harshddes/VacuumSystem-Arduino/docs/index/A000066-pins.md

# A000066 pin index

Package note: DIP-28 socket, ATmega328P-PU
Source schematic: `docs/uno-r3-dip-A000066/cad/UNO-TH_Rev3e.sch`
SHA-256: `f44b5a90b74757e91477fb3adb776ffc556d9ea5dd8cc6ef3c79c1bbba0aee23`

Each row is a header leg from the Eagle schematic. The net name is the name on that drawing. Chip legs are the worker or USB chip pins tied to the same net.

| Header | Pin | Manual name | Net | Chip on that net | Also on that net |
| --- | --- | --- | --- | --- | --- |
| AD | 1 | A0 | AD0 | ZU4.(ADC0)PC0) pad 23 | TP_A0.TESTP pad X |
| AD | 2 | A1 | AD1 | ZU4.(ADC1)PC1 pad 24 | TP_A1.TESTP pad X |
| AD | 3 | A2 | AD2 | ZU4.(ADC2)PC2 pad 25 | TP_A2.TESTP pad X |
| AD | 4 | A3 | AD3 | ZU4.(ADC3)PC3 pad 26 | TP_A3.TESTP pad X |
| AD | 5 | A4 | AD4/SDA | ZU4.(ADC4)PC4 pad 27 | TP_A4.TESTP pad X<br>IOH.9 pad 9 = 10x1F-H8.5<br>TP_SDA.TESTP pad X |
| AD | 6 | A5 | AD5/SCL | ZU4.(ADC5)PC5 pad 28 | TP_A5.TESTP pad X<br>IOH.10 pad 10 = 10x1F-H8.5<br>TP_SCL.TESTP pad X |
| ICSP | 1 |  | MISO | ZU4.(MISO)PB4 pad 18 | IOH.5 pad 5 = 10x1F-H8.5<br>TP_12.TESTP pad X |
| ICSP | 2 |  | +5V | U3.VCC pad 4 = ATMEGA16U2-MU(R)<br>U3.AVCC pad 32 = ATMEGA16U2-MU(R)<br>ZU4.VCC pad 7 | POWER.5 pad 5 = 8x1F-H8.5<br>POWER.2 pad 2 = 8x1F-H8.5<br>RN4.1 pad 3 = 1K<br>RN4.1 pad 4 = 1K<br>RN2.1 pad 2 = 1K<br>RN2.1 pad 3 = 1K<br>+ 19 more in pin-index.jsonl |
| ICSP | 3 |  | SCK | ZU4.(SCK)PB5 pad 19 | IOH.6 pad 6 = 10x1F-H8.5<br>TP_13.TESTP pad X<br>U5.+IN pad 5 = LMV358IDGKR |
| ICSP | 4 |  | MOSI | ZU4.(MOSI)PB3 pad 17 | IOH.4 pad 4 = 10x1F-H8.5<br>TP_11.TESTP pad X |
| ICSP | 5 |  | RESET | ZU4.RESET pad 1 | C5.2 pad 2 = 100n<br>RESET-EN.2 pad 2<br>RESET-EN.1 pad 1<br>RN1.1 pad 4 = 10K<br>RESET.4 pad 4 = TS42031-160R-TR-7260<br>RESET.3 pad 3 = TS42031-160R-TR-7260<br>+ 3 more in pin-index.jsonl |
| ICSP | 6 |  | GND | ZU4.GND pad 8<br>ZU4.AGND pad 22<br>U3.GND pad 3 = ATMEGA16U2-MU(R)<br>U3.PAD pad 33 = ATMEGA16U2-MU(R) | C6.1 pad 1 = 100n<br>C10.1 pad 1 = 100n<br>C2.1 pad 1 = 100n<br>PC2.- pad - = 47u<br>PC1.- pad - = 47u<br>POWER.6 pad 6 = 8x1F-H8.5<br>+ 22 more in pin-index.jsonl |
| ICSP1 | 1 |  | MISO2 | U3.(PD0/MISO/PCINT3)PB3 pad 17 = ATMEGA16U2-MU(R) | TP_MISO2.TESTP pad X |
| ICSP1 | 2 |  | +5V | U3.VCC pad 4 = ATMEGA16U2-MU(R)<br>U3.AVCC pad 32 = ATMEGA16U2-MU(R)<br>ZU4.VCC pad 7 | ICSP.2 pad 2 = 3x2 M<br>POWER.5 pad 5 = 8x1F-H8.5<br>POWER.2 pad 2 = 8x1F-H8.5<br>RN4.1 pad 3 = 1K<br>RN4.1 pad 4 = 1K<br>RN2.1 pad 2 = 1K<br>+ 19 more in pin-index.jsonl |
| ICSP1 | 3 |  | SCK2 | U3.(SCLK/PCINT1)PB1 pad 15 = ATMEGA16U2-MU(R) | TP_SCK2.TESTP pad X |
| ICSP1 | 4 |  | MOSI2 | U3.(PDI/MOSI/PCINT2)PB2 pad 16 = ATMEGA16U2-MU(R) | TP_MOSI2.TESTP pad X |
| ICSP1 | 5 |  | RESET2 | U3.RESET(PC1/DW) pad 24 = ATMEGA16U2-MU(R) | RN1.2 pad 6 = 10K<br>D3.A pad A = CD1206-S01575<br>TP_RESET2.TESTP pad X |
| ICSP1 | 6 |  | GND | ZU4.GND pad 8<br>ZU4.AGND pad 22<br>U3.GND pad 3 = ATMEGA16U2-MU(R)<br>U3.PAD pad 33 = ATMEGA16U2-MU(R) | ICSP.6 pad 6 = 3x2 M<br>C6.1 pad 1 = 100n<br>C10.1 pad 1 = 100n<br>C2.1 pad 1 = 100n<br>PC2.- pad - = 47u<br>PC1.- pad - = 47u<br>+ 22 more in pin-index.jsonl |
| IOH | 1 | D8 | IO8 | ZU4.(ICP)PB0 pad 14 | TP_8.TESTP pad X |
| IOH | 2 | D9 | IO9 | ZU4.(OC1)PB1 pad 15 | TP_9.TESTP pad X |
| IOH | 3 | D10 | SS | ZU4.(SS)PB2 pad 16 | TP_10.TESTP pad X |
| IOH | 4 | D11 | MOSI | ZU4.(MOSI)PB3 pad 17 | ICSP.4 pad 4 = 3x2 M<br>TP_11.TESTP pad X |
| IOH | 5 | D12 | MISO | ZU4.(MISO)PB4 pad 18 | ICSP.1 pad 1 = 3x2 M<br>TP_12.TESTP pad X |
| IOH | 6 | D13 | SCK | ZU4.(SCK)PB5 pad 19 | ICSP.3 pad 3 = 3x2 M<br>TP_13.TESTP pad X<br>U5.+IN pad 5 = LMV358IDGKR |
| IOH | 7 | GND | GND | ZU4.GND pad 8<br>ZU4.AGND pad 22<br>U3.GND pad 3 = ATMEGA16U2-MU(R)<br>U3.PAD pad 33 = ATMEGA16U2-MU(R) | ICSP.6 pad 6 = 3x2 M<br>C6.1 pad 1 = 100n<br>C10.1 pad 1 = 100n<br>C2.1 pad 1 = 100n<br>PC2.- pad - = 47u<br>PC1.- pad - = 47u<br>+ 22 more in pin-index.jsonl |
| IOH | 8 | AREF | AREF | ZU4.AREF pad 21 | C4.2 pad 2 = 100n<br>TP_AREF.TESTP pad X |
| IOH | 9 | A4/SD4 | AD4/SDA | ZU4.(ADC4)PC4 pad 27 | AD.5 pad 5 = 6x1F-H8.5<br>TP_A4.TESTP pad X<br>TP_SDA.TESTP pad X |
| IOH | 10 | A5/SD5 | AD5/SCL | ZU4.(ADC5)PC5 pad 28 | AD.6 pad 6 = 6x1F-H8.5<br>TP_A5.TESTP pad X<br>TP_SCL.TESTP pad X |
| IOL | 1 | D0 | IO0 | ZU4.(RXD)PD0 pad 2 | RN4.1 pad 2 = 1K<br>TP_0.TESTP pad X |
| IOL | 2 | D1 | IO1 | ZU4.(TXD)PD1 pad 3 | RN4.1 pad 1 = 1K<br>TP_1.TESTP pad X |
| IOL | 3 | D2 | IO2 | ZU4.(INT0)PD2 pad 4 | TP_2.TESTP pad X |
| IOL | 4 | D3 | IO3 | ZU4.(INT1)PD3 pad 5 | TP_3.TESTP pad X |
| IOL | 5 | D4 | IO4 | ZU4.(T0)PD4 pad 6 | TP_4.TESTP pad X |
| IOL | 6 | D5 | IO5 | ZU4.(T1)PD5 pad 11 | TP_5.TESTP pad X |
| IOL | 7 | D6 | IO6 | ZU4.(AIN0)PD6 pad 12 | TP_6.TESTP pad X |
| IOL | 8 | D7 | IO7 | ZU4.(AIN1)PD7 pad 13 | TP_7.TESTP pad X |
| JP2 | 1 |  | PB4 | U3.(T1/PCINT4)PB4 pad 18 = ATMEGA16U2-MU(R) | TP_PB4.TESTP pad X |
| JP2 | 2 |  | PB6 | U3.(PCINT6)PB6 pad 20 = ATMEGA16U2-MU(R) | TP_PB6.TESTP pad X |
| JP2 | 3 |  | PB5 | U3.(PCINT5)PB5 pad 19 = ATMEGA16U2-MU(R) | TP_PB5.TESTP pad X |
| JP2 | 4 |  | PB7 | U3.(PCINT7/OC0A/OC1C)PB7 pad 21 = ATMEGA16U2-MU(R) | TP_PB7.TESTP pad X |
| POWER | 1 | NC | (no wire) |  |  |
| POWER | 2 | IOREF | +5V | U3.VCC pad 4 = ATMEGA16U2-MU(R)<br>U3.AVCC pad 32 = ATMEGA16U2-MU(R)<br>ZU4.VCC pad 7 | ICSP.2 pad 2 = 3x2 M<br>RN4.1 pad 3 = 1K<br>RN4.1 pad 4 = 1K<br>RN2.1 pad 2 = 1K<br>RN2.1 pad 3 = 1K<br>C1.2 pad 2 = 100n<br>+ 18 more in pin-index.jsonl |
| POWER | 3 | Reset | RESET | ZU4.RESET pad 1 | ICSP.5 pad 5 = 3x2 M<br>C5.2 pad 2 = 100n<br>RESET-EN.2 pad 2<br>RESET-EN.1 pad 1<br>RN1.1 pad 4 = 10K<br>RESET.4 pad 4 = TS42031-160R-TR-7260<br>+ 3 more in pin-index.jsonl |
| POWER | 4 | +3V3 | +3V3 |  | C3.2 pad 2 = 1u<br>U2.OUT pad 5 = LP2985-33DBVR<br>TP_3V3.TESTP pad X<br>U5.-IN pad 2 = LMV358IDGKR |
| POWER | 5 | +5V | +5V | U3.VCC pad 4 = ATMEGA16U2-MU(R)<br>U3.AVCC pad 32 = ATMEGA16U2-MU(R)<br>ZU4.VCC pad 7 | ICSP.2 pad 2 = 3x2 M<br>RN4.1 pad 3 = 1K<br>RN4.1 pad 4 = 1K<br>RN2.1 pad 2 = 1K<br>RN2.1 pad 3 = 1K<br>C1.2 pad 2 = 100n<br>+ 18 more in pin-index.jsonl |
| POWER | 6 | GND | GND | ZU4.GND pad 8<br>ZU4.AGND pad 22<br>U3.GND pad 3 = ATMEGA16U2-MU(R)<br>U3.PAD pad 33 = ATMEGA16U2-MU(R) | ICSP.6 pad 6 = 3x2 M<br>C6.1 pad 1 = 100n<br>C10.1 pad 1 = 100n<br>C2.1 pad 1 = 100n<br>PC2.- pad - = 47u<br>PC1.- pad - = 47u<br>+ 21 more in pin-index.jsonl |
| POWER | 7 | GND | GND | ZU4.GND pad 8<br>ZU4.AGND pad 22<br>U3.GND pad 3 = ATMEGA16U2-MU(R)<br>U3.PAD pad 33 = ATMEGA16U2-MU(R) | ICSP.6 pad 6 = 3x2 M<br>C6.1 pad 1 = 100n<br>C10.1 pad 1 = 100n<br>C2.1 pad 1 = 100n<br>PC2.- pad - = 47u<br>PC1.- pad - = 47u<br>+ 21 more in pin-index.jsonl |
| POWER | 8 | VIN | VIN |  | U1.IN pad 3 = NCP1117ST50T3G<br>PC1.+ pad + = 47u<br>D1.C pad C = M7<br>TP_VIN.TESTP pad X<br>RN1.2 pad 8 = 10K |

## Worker chip

| Pin name | Pad | Port | Net |
| --- | --- | --- | --- |
| (ADC0)PC0) | 23 | PC0 | AD0 |
| (ADC1)PC1 | 24 | PC1 | AD1 |
| (ADC2)PC2 | 25 | PC2 | AD2 |
| (ADC3)PC3 | 26 | PC3 | AD3 |
| (ADC4)PC4 | 27 | PC4 | AD4/SDA |
| (ADC5)PC5 | 28 | PC5 | AD5/SCL |
| (AIN0)PD6 | 12 | PD6 | IO6 |
| (AIN1)PD7 | 13 | PD7 | IO7 |
| (ICP)PB0 | 14 | PB0 | IO8 |
| (INT0)PD2 | 4 | PD2 | IO2 |
| (INT1)PD3 | 5 | PD3 | IO3 |
| (MISO)PB4 | 18 | PB4 | MISO |
| (MOSI)PB3 | 17 | PB3 | MOSI |
| (OC1)PB1 | 15 | PB1 | IO9 |
| (RXD)PD0 | 2 | PD0 | IO0 |
| (SCK)PB5 | 19 | PB5 | SCK |
| (SS)PB2 | 16 | PB2 | SS |
| (T0)PD4 | 6 | PD4 | IO4 |
| (T1)PD5 | 11 | PD5 | IO5 |
| (TXD)PD1 | 3 | PD1 | IO1 |
| AGND | 22 | AGND | GND |
| AREF | 21 | AREF | AREF |
| AVCC | 20 | AVCC | AVCC |
| GND | 8 | GND | GND |
| RESET | 1 | RESET | RESET |
| VCC | 7 | VCC | +5V |
| XTAL1 | 9 | XTAL1 | XTAL1 |
| XTAL2 | 10 | XTAL2 | XTAL2 |
