harshddes/VacuumSystem-Arduino/docs/index/A000073-pins.md

# A000073 pin index

Package note: SMD, schematic value ATmega328P-MU
Source schematic: `docs/uno-r3-smd-A000073/cad/UNOSMD_V3.sch`
SHA-256: `a00be79309468536b36c90b12942b9729759bdf1a425e4f94c5a1e9a9fc9a688`

Each row is a header leg from the Eagle schematic. The net name is the name on that drawing. Chip legs are the worker or USB chip pins tied to the same net.

| Header | Pin | Manual name | Net | Chip on that net | Also on that net |
| --- | --- | --- | --- | --- | --- |
| ICSP | 1 |  | MISO | U4.PB4(MISO) pad 16 = ATMEGA328P-MU | J2.13 pad 13 = - |
| ICSP | 2 |  | +5V | U3.VCC pad 4 = 16U2<br>U3.AVCC pad 32 = 16U2<br>U4.VCC@1 pad 4 = ATMEGA328P-MU<br>U4.VCC@2 pad 6 = ATMEGA328P-MU | L2.1 pad 1 = 10uH<br>RN4.1 pad 3 = 1K<br>RN4.1 pad 4 = 1K<br>RN2.1 pad 2 = 1K<br>RN2.1 pad 3 = 1K<br>C1.2 pad 2 = 100n<br>+ 18 more in pin-index.jsonl |
| ICSP | 3 |  | SCK | U4.PB5(SCK) pad 17 = ATMEGA328P-MU | U5.+IN pad 5 = LMV358IDGKR<br>J2.14 pad 14 = - |
| ICSP | 4 |  | MOSI | U4.PB3(MOSI/OC2) pad 15 = ATMEGA328P-MU | J2.12 pad 12 = - |
| ICSP | 5 |  | RESET | U4.PC6(/RESET) pad 29 = ATMEGA328P-MU | C5.2 pad 2 = 100n<br>RESET-EN.2 pad 2<br>RESET-EN.1 pad 1<br>RN1.1 pad 4 = 10K<br>RESET.4 pad 4 = TS42031-160R-TR-7260<br>RESET.3 pad 3 = TS42031-160R-TR-7260<br>+ 2 more in pin-index.jsonl |
| ICSP | 6 |  | GND | U4.GND@1 pad 3 = ATMEGA328P-MU<br>U4.GND@2 pad 5 = ATMEGA328P-MU<br>U4.AGND pad 21 = ATMEGA328P-MU<br>U3.GND pad 3 = 16U2<br>U3.PAD pad EXP = 16U2 | C6.1 pad 1 = 100n<br>C2.1 pad 1 = 100n<br>PC2.- pad - = 47u<br>PC1.- pad - = 47u<br>ON.C pad C = GREEN<br>X1.1 pad 1<br>+ 22 more in pin-index.jsonl |
| ICSP1 | 1 |  | MISO2 | U3.(PD0/MISO/PCINT3)PB3 pad 17 = 16U2 | TP_MISO2.TESTP pad X |
| ICSP1 | 2 |  | +5V | U3.VCC pad 4 = 16U2<br>U3.AVCC pad 32 = 16U2<br>U4.VCC@1 pad 4 = ATMEGA328P-MU<br>U4.VCC@2 pad 6 = ATMEGA328P-MU | ICSP.2 pad 2 = 3x2 M<br>L2.1 pad 1 = 10uH<br>RN4.1 pad 3 = 1K<br>RN4.1 pad 4 = 1K<br>RN2.1 pad 2 = 1K<br>RN2.1 pad 3 = 1K<br>+ 18 more in pin-index.jsonl |
| ICSP1 | 3 |  | SCK2 | U3.(SCLK/PCINT1)PB1 pad 15 = 16U2 | TP_SCK2.TESTP pad X |
| ICSP1 | 4 |  | MOSI2 | U3.(PDI/MOSI/PCINT2)PB2 pad 16 = 16U2 | TP_MOSI2.TESTP pad X |
| ICSP1 | 5 |  | RESET2 | U3.RESET(PC1/DW) pad 24 = 16U2 | RN1.2 pad 6 = 10K<br>D3.A pad A = CD1206-S01575<br>TP_RESET2.TESTP pad X |
| ICSP1 | 6 |  | GND | U4.GND@1 pad 3 = ATMEGA328P-MU<br>U4.GND@2 pad 5 = ATMEGA328P-MU<br>U4.AGND pad 21 = ATMEGA328P-MU<br>U3.GND pad 3 = 16U2<br>U3.PAD pad EXP = 16U2 | ICSP.6 pad 6 = 3x2 M<br>C6.1 pad 1 = 100n<br>C2.1 pad 1 = 100n<br>PC2.- pad - = 47u<br>PC1.- pad - = 47u<br>ON.C pad C = GREEN<br>+ 22 more in pin-index.jsonl |
| J1 | 1 | NC | (no wire) |  |  |
| J1 | 2 | IOREF | +5V | U3.VCC pad 4 = 16U2<br>U3.AVCC pad 32 = 16U2<br>U4.VCC@1 pad 4 = ATMEGA328P-MU<br>U4.VCC@2 pad 6 = ATMEGA328P-MU | ICSP.2 pad 2 = 3x2 M<br>L2.1 pad 1 = 10uH<br>RN4.1 pad 3 = 1K<br>RN4.1 pad 4 = 1K<br>RN2.1 pad 2 = 1K<br>RN2.1 pad 3 = 1K<br>+ 17 more in pin-index.jsonl |
| J1 | 3 | Reset | RESET | U4.PC6(/RESET) pad 29 = ATMEGA328P-MU | ICSP.5 pad 5 = 3x2 M<br>C5.2 pad 2 = 100n<br>RESET-EN.2 pad 2<br>RESET-EN.1 pad 1<br>RN1.1 pad 4 = 10K<br>RESET.4 pad 4 = TS42031-160R-TR-7260<br>+ 2 more in pin-index.jsonl |
| J1 | 4 | +3V3 | +3V3 |  | C3.2 pad 2 = 1u<br>U2.OUT pad 5 = LP2985-33DBVR<br>U5.-IN pad 2 = LMV358IDGKR |
| J1 | 5 | +5V | +5V | U3.VCC pad 4 = 16U2<br>U3.AVCC pad 32 = 16U2<br>U4.VCC@1 pad 4 = ATMEGA328P-MU<br>U4.VCC@2 pad 6 = ATMEGA328P-MU | ICSP.2 pad 2 = 3x2 M<br>L2.1 pad 1 = 10uH<br>RN4.1 pad 3 = 1K<br>RN4.1 pad 4 = 1K<br>RN2.1 pad 2 = 1K<br>RN2.1 pad 3 = 1K<br>+ 17 more in pin-index.jsonl |
| J1 | 6 | GND | GND | U4.GND@1 pad 3 = ATMEGA328P-MU<br>U4.GND@2 pad 5 = ATMEGA328P-MU<br>U4.AGND pad 21 = ATMEGA328P-MU<br>U3.GND pad 3 = 16U2<br>U3.PAD pad EXP = 16U2 | ICSP.6 pad 6 = 3x2 M<br>C6.1 pad 1 = 100n<br>C2.1 pad 1 = 100n<br>PC2.- pad - = 47u<br>PC1.- pad - = 47u<br>ON.C pad C = GREEN<br>+ 21 more in pin-index.jsonl |
| J1 | 7 | GND | GND | U4.GND@1 pad 3 = ATMEGA328P-MU<br>U4.GND@2 pad 5 = ATMEGA328P-MU<br>U4.AGND pad 21 = ATMEGA328P-MU<br>U3.GND pad 3 = 16U2<br>U3.PAD pad EXP = 16U2 | ICSP.6 pad 6 = 3x2 M<br>C6.1 pad 1 = 100n<br>C2.1 pad 1 = 100n<br>PC2.- pad - = 47u<br>PC1.- pad - = 47u<br>ON.C pad C = GREEN<br>+ 21 more in pin-index.jsonl |
| J1 | 8 | VIN | VIN |  | U1.IN pad 3 = NCP1117ST50T3G<br>PC1.+ pad + = 47u<br>D1.C pad C = M7<br>RN1.2 pad 8 = 10K |
| J1 | 9 | A0 | A0 | U4.PC0(ADC0) pad 23 = ATMEGA328P-MU |  |
| J1 | 10 | A1 | A1 | U4.PC1(ADC1) pad 24 = ATMEGA328P-MU |  |
| J1 | 11 | A2 | A2 | U4.PC2(ADC2) pad 25 = ATMEGA328P-MU |  |
| J1 | 12 | A3 | A3 | U4.PC3(ADC3) pad 26 = ATMEGA328P-MU |  |
| J1 | 13 | A4 | A4/SDA | U4.PC4(ADC4/SDA) pad 27 = ATMEGA328P-MU | J2.17 pad 17 = - |
| J1 | 14 | A5 | A5/SCL | U4.PC5(ADC5/SCL) pad 28 = ATMEGA328P-MU | J2.18 pad 18 = - |
| J2 | 1 | D0 | IO0 | U4.PD0(RXD) pad 30 = ATMEGA328P-MU | RN4.1 pad 2 = 1K |
| J2 | 2 | D1 | IO1 | U4.PD1(TXD) pad 31 = ATMEGA328P-MU | RN4.1 pad 1 = 1K |
| J2 | 3 | D2 | IO2 | U4.PD2(INT0) pad 32 = ATMEGA328P-MU |  |
| J2 | 4 | D3 | IO3 | U4.PD3(INT1) pad 1 = ATMEGA328P-MU |  |
| J2 | 5 | D4 | IO4 | U4.PD4(XCK/T0) pad 2 = ATMEGA328P-MU |  |
| J2 | 6 | D5 | IO5 | U4.PD5(T1) pad 9 = ATMEGA328P-MU |  |
| J2 | 7 | D6 | IO6 | U4.PD6(AIN0) pad 10 = ATMEGA328P-MU |  |
| J2 | 8 | D7 | IO7 | U4.PD7(AIN1) pad 11 = ATMEGA328P-MU |  |
| J2 | 9 | D8 | IO8 | U4.PB0(ICP) pad 12 = ATMEGA328P-MU |  |
| J2 | 10 | D9 | IO9 | U4.PB1(OC1A) pad 13 = ATMEGA328P-MU |  |
| J2 | 11 | D10 | SS | U4.PB2(SS/OC1B) pad 14 = ATMEGA328P-MU |  |
| J2 | 12 | D11 | MOSI | U4.PB3(MOSI/OC2) pad 15 = ATMEGA328P-MU | ICSP.4 pad 4 = 3x2 M |
| J2 | 13 | D12 | MISO | U4.PB4(MISO) pad 16 = ATMEGA328P-MU | ICSP.1 pad 1 = 3x2 M |
| J2 | 14 | D13 | SCK | U4.PB5(SCK) pad 17 = ATMEGA328P-MU | ICSP.3 pad 3 = 3x2 M<br>U5.+IN pad 5 = LMV358IDGKR |
| J2 | 15 | GND | GND | U4.GND@1 pad 3 = ATMEGA328P-MU<br>U4.GND@2 pad 5 = ATMEGA328P-MU<br>U4.AGND pad 21 = ATMEGA328P-MU<br>U3.GND pad 3 = 16U2<br>U3.PAD pad EXP = 16U2 | ICSP.6 pad 6 = 3x2 M<br>C6.1 pad 1 = 100n<br>C2.1 pad 1 = 100n<br>PC2.- pad - = 47u<br>PC1.- pad - = 47u<br>ON.C pad C = GREEN<br>+ 22 more in pin-index.jsonl |
| J2 | 16 | AREF | AREF | U4.AREF pad 20 = ATMEGA328P-MU | C4.2 pad 2 = 100n |
| J2 | 17 | A4/SD4 | A4/SDA | U4.PC4(ADC4/SDA) pad 27 = ATMEGA328P-MU | J1.13 pad 13 = - |
| J2 | 18 | A5/SD5 | A5/SCL | U4.PC5(ADC5/SCL) pad 28 = ATMEGA328P-MU | J1.14 pad 14 = - |
| JP2 | 1 |  | PB4 | U3.(T1/PCINT4)PB4 pad 18 = 16U2 |  |
| JP2 | 2 |  | PB6 | U3.(PCINT6)PB6 pad 20 = 16U2 |  |
| JP2 | 3 |  | PB5 | U3.(PCINT5)PB5 pad 19 = 16U2 |  |
| JP2 | 4 |  | PB7 | U3.(PCINT7/OC0A/OC1C)PB7 pad 21 = 16U2 |  |

## Worker chip

| Pin name | Pad | Port | Net |
| --- | --- | --- | --- |
| ADC6 | 19 | ADC6 | (no wire) |
| ADC7 | 22 | ADC7 | (no wire) |
| AGND | 21 | AGND | GND |
| AREF | 20 | AREF | AREF |
| AVCC | 18 | AVCC | N$4 |
| GND@1 | 3 | GND@1 | GND |
| GND@2 | 5 | GND@2 | GND |
| PB0(ICP) | 12 | PB0 | IO8 |
| PB1(OC1A) | 13 | PB1 | IO9 |
| PB2(SS/OC1B) | 14 | PB2 | SS |
| PB3(MOSI/OC2) | 15 | PB3 | MOSI |
| PB4(MISO) | 16 | PB4 | MISO |
| PB5(SCK) | 17 | PB5 | SCK |
| PB6(XTAL1/TOSC1) | 7 | PB6 | XTAL1 |
| PB7(XTAL2/TOSC2) | 8 | PB7 | XTAL2 |
| PC0(ADC0) | 23 | PC0 | A0 |
| PC1(ADC1) | 24 | PC1 | A1 |
| PC2(ADC2) | 25 | PC2 | A2 |
| PC3(ADC3) | 26 | PC3 | A3 |
| PC4(ADC4/SDA) | 27 | PC4 | A4/SDA |
| PC5(ADC5/SCL) | 28 | PC5 | A5/SCL |
| PC6(/RESET) | 29 | PC6 | RESET |
| PD0(RXD) | 30 | PD0 | IO0 |
| PD1(TXD) | 31 | PD1 | IO1 |
| PD2(INT0) | 32 | PD2 | IO2 |
| PD3(INT1) | 1 | PD3 | IO3 |
| PD4(XCK/T0) | 2 | PD4 | IO4 |
| PD5(T1) | 9 | PD5 | IO5 |
| PD6(AIN0) | 10 | PD6 | IO6 |
| PD7(AIN1) | 11 | PD7 | IO7 |
| VCC@1 | 4 | VCC@1 | +5V |
| VCC@2 | 6 | VCC@2 | +5V |
