harshddes/VacuumSystem-Arduino/docs/index/text/A000066-schematics.txt

===== A000066-schematics.pdf PAGE 1 =====

                           1                                                                           2                                                                                    3                                                             4                                                                                                     5                                                                       6                                                  7                                                                       8

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

                                                                                                                                                                                                                                                                                                                                                           TP_RX           TP_TX

                                                                                                                                                                    GND

                           1                                                                           2                                                                                    3                                                             4                                                                                                     5                                                                       6                                                  7                                                                       8

===== A000066-schematics.pdf PAGE 2 =====

This project's hardware is licensed under the Creative Commons Attribution-ShareAlike 4.0 International

 License. To view a copy of this license, visit https://creativecommons.org/licenses/by-sa/4.0/deed.en
