harshddes/VacuumSystem-Arduino/development/kicad/maize-controller/maize-controller-top.png

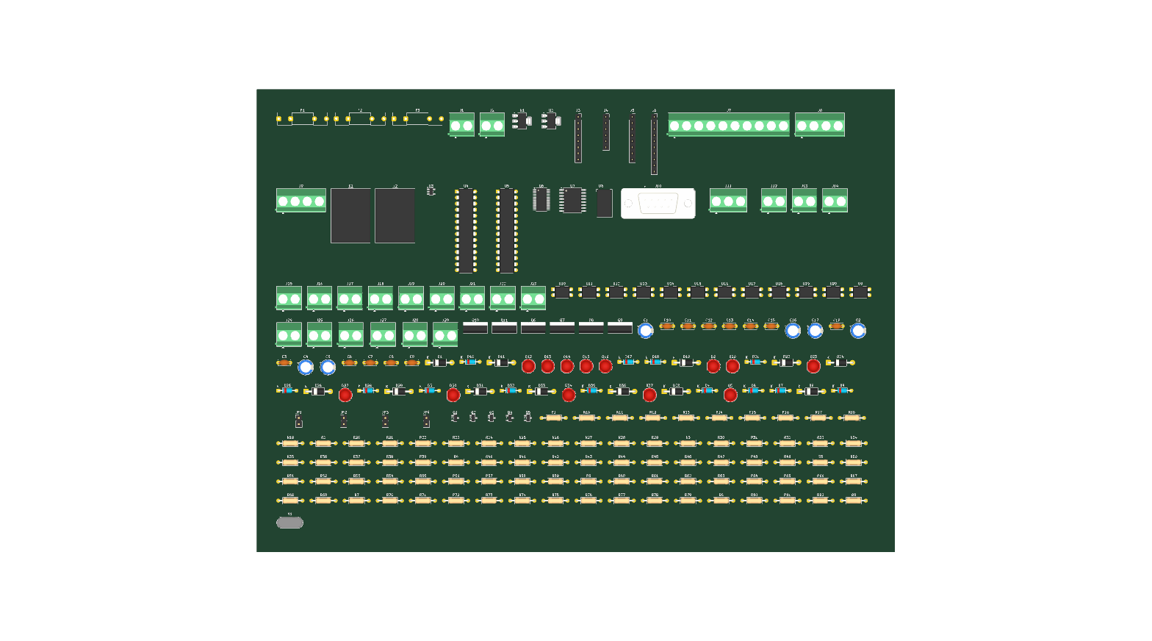
development/kicad/maize-controller/maize-controller-top.png
