harshddes/VacuumSystem-Arduino/development/procurement/maize-uno-bom.xlsx

Sheet: Shopping
MAIZE • UNO R3 PROCUREMENT & DEVELOPMENT
Rev 09/10/2026 • USD excl. shipping/tax/tariffs • Five build phases; price-check dates are recorded per line.
Phase 1 buy-now packs (wires optional) |  |  |  | $8.20 |  |  | $8.20 bench packs; optional 40-wire purchase adds $3.90. HOLD is not a full-system quote; model-dependent unknown prices remain Quote.
Priced HOLD candidates only |  |  |  | $1003.50
Rows without a verified price |  |  |  | 28
Edit amber cells (decision, quantities, prices). “Quote” means unknown price, never a free part. Zero quantity means optional/not currently selected.
Board and laptop already owned. No PLC, turbo, second Arduino, touchscreen or LabVIEW purchase required for this stand.
ID | Phase | Decision | Item / order unit | Qty | USD/unit | USD/line | Required specification | Supplier / part | Stock checked 07/10/2026 | Confirm before ordering | Product / evidence URL | Review evidence / caveat
O01 | 1 | Reuse | Arduino Uno R3 | 1 | $0.00 | $0.00 | 5 V logic; USB shared with one hardware UART | Owned | User reports owned | Use actual Uno board selection | https://docs.arduino.cc/hardware/uno-rev3/ | Owned inventory
O02 | 1 | Reuse | Breadboard + 20 male-to-male jumpers | 1 | $0.00 | $0.00 | 20 wires used; 40 on hand recommended; no field connections | Owned | User reports owned | Replace with secured assembly before live operation |  | Owned inventory
O03 | 1–2 | Reuse | Laptop + USB A–B data cable | 1 | $0.00 | $0.00 | Laptop is monitor/logging tool, not final controller | Owned / borrow cable | Laptop owned; cable not confirmed | Check cable exists; USB-C laptop may need correct adapter |  | Owned inventory; cable availability unverified
B01 | 1 | Buy now | 470 ohm resistors, 25-pack | 1 | $0.75 | $0.75 | Use one resistor per LED; three needed initially | Adafruit 2781 | Listed price rechecked 09/10/2026 | Reuse lab resistors if available | https://www.adafruit.com/product/2781 | No review rating verified; OEM or authorized distributor; price checked 09/10/2026
B02 | 1 | Buy now | Green 3 mm LEDs, 25-pack | 1 | $4.95 | $4.95 | Three LED outputs: accepted cryo, vent, disarmed/rejected | Adafruit 779 | Listed price rechecked 09/10/2026 | Green-only pack is sufficient; labels distinguish functions | https://www.adafruit.com/product/779 | No review rating verified; OEM or authorized distributor; price checked 09/10/2026
B03 | 1 | Buy now | 12 mm momentary buttons, 10-pack | 1 | $2.50 | $2.50 | Three buttons used: CRYO request, VENT request, RE-ARM | Adafruit 1119 | Listed price rechecked 09/10/2026 | Reuse lab switch/button if available | https://www.adafruit.com/product/1119 | No review rating verified; OEM or authorized distributor; price checked 09/10/2026
T01 | 1–5 | Borrow | Digital multimeter with leads | 1 |  | Quote | Continuity and DC voltage; lab instrument preferred | Borrow from lab | Not purchased | Needed before connecting any real equipment |  | Borrow rather than buy an out-of-stock meter
T02 | 3–5 | Borrow | Soldering station, solder, stripper, crimper | 1 |  | Quote | Use correct ferrule/crimp tool for selected terminals | Borrow from lab | Not purchased | Needed for secured final assembly |  | Tool bundle quantities depend on assembly
G01 | 2 | Hold | I2C-to-dual-UART module | 1 | $8.00 | $8.00 | DFR0627; 3.3–5.5 V; independent buffered serial port | DigiKey / DFRobot DFR0627 | Listed price rechecked 09/10/2026 | Only after gauge protocol/interface confirmed; keeps USB serial free | https://www.digikey.com/en/products/detail/dfrobot/DFR0627/12091972 | No review rating verified; OEM or authorized distributor; price checked 09/10/2026
G02 | 2 | Hold | Isolated RS485-to-UART module | 1 | $19.90 | $19.90 | DFR0845; 3.3–5 V input; signal and power isolation | DigiKey / DFRobot DFR0845 | Listed price rechecked 09/10/2026 | RS485 gauge only; its 12 V/160 mA output is not a Hornet PSU | https://www.digikey.com/en/products/detail/dfrobot/DFR0845/15283078 | No review rating verified; OEM or authorized distributor; price checked 09/10/2026
G03 | 2 | Hold | Male DE-9 screw-terminal breakout | 1 | $2.95 | $2.95 | Mates Hornet female RS485 socket; verify pin-number orientation | Adafruit 3123 | Snapshot 08/10/2026; recheck at checkout | Separate shielded cable and instrument supply still required | https://www.adafruit.com/product/3123 | No review rating verified; OEM product; price checked 08/10/2026
G04 | 2 | Reuse | Existing Hornet instrument supply, if present | 1 | $0.00 | $0.00 | IGM402YFD reported 20-28 VDC; conservative archived manual budget 30 W minimum | Owned? verify | Presence and rating not yet verified | IGM401/402 current product pages specify 20–28 Vdc; never power from Uno | https://www.instrutechinc.com/ | Condition/presence unverified
G05 | 2 | Hold | Low-vacuum sensor, only if CVG101GC unavailable | 1 |  | Quote | Locate and test reported Worker Bee first; no new gauge purchase yet | InstruTech / compatible gauge OEM | Model dependent | IGM401 ion-only is insufficient for full roughing/vent; IGM402 needs a working compatible convection sensor | https://www.instrutechinc.com/ | Reuse existing rough gauge first
G06 | 4 | Hold | Filament OFF control + confirmed OFF/status interface | 1 |  | Quote | Model-supported control ownership, wiring and readback | Gauge OEM / DigiKey | Model dependent | Vent permission requires documented filament-off confirmation; not just command sent | https://www.instrutechinc.com/ | Serial/control semantics must be verified
V01 | 3 | Reuse | Existing large cryo gate / actuator | 1 | $0.00 | $0.00 | Photograph appears pneumatic: ports C/O; exact valve unidentified | Existing photographed assembly | Unverified | Check model, installed route, actuation and failure position; do not replace yet |  | Photo inference, not confirmed identification
V02 | 3 | Hold | Cryo gate pneumatic pilot / solenoid | 1 |  | Quote | 3/2 vs 5/2; coil volts, AC/DC, ports and failure behavior must match actuator | Gate OEM / appropriate pneumatic supplier | Model dependent | Select after actual gate manual; cannot infer coil/pilot from C/O labels alone |  | No SKU until actuator identified
V03 | 3–4 | Hold | Open/closed feedback for existing cryo gate | 1 |  | Quote | Two end positions; contacts or sensor outputs electrically identified | Valve OEM / compatible sensors | May already exist | Check white wires and wiring diagram; sensors must prove actual travel |  | Price/quantity are a retrofit kit placeholder; may become reuse
E01 | 3 | Hold | Eight-channel DC solenoid driver | 1 | $14.95 | $14.95 | Adafruit 6318: I2C; 3–24 V DC loads; flyback; thermal/current limits require check | Adafruit 6318 | Price snapshot; availability must be rechecked | DC coils only; eight extra GPIO can reduce need for separate expander | https://www.adafruit.com/product/6318 | No product review rating verified; selected for OEM documentation/support. Price snapshot 07/10/2026 unless updated below.
E02 | 3 | Optional | Single-channel MOSFET driver, alternative | 0 | $3.95 | $0.00 | Adafruit 5648; use only within documented load ratings | Adafruit 5648 | Price snapshot; availability must be rechecked | Optional lower-cost one-coil proof; not additional to E01 by default | https://www.adafruit.com/product/5648 | No product review rating verified; selected for OEM documentation/support. Price snapshot 07/10/2026 unless updated below.
E03 | 3–5 | Hold | External supervised output enable / watchdog circuit | 1 |  | Quote | Outputs inhibited at startup/fault; design actual close path; I2C outputs may remain latched | Component supplier after circuit review | Design dependent | Necessary for live controller; does not make Uno safety-certified |  | Need final actuator and single-fault assessment before circuit SKU
E04 | 3–5 | Hold | Field input conditioning / isolation | 1 |  | Quote | Reed dry contacts vs PNP/NPN/24 V outputs; validate thresholds, filtering and disconnect detection | DigiKey / actual sensor OEM | Design dependent | Never connect unidentified 24 V signals directly to Uno |  | Channel count follows signal inventory
E05 | 3 | Hold | 24 V valve-only desktop supply, candidate | 1 | $14.30 | $14.30 | Mean Well GST25A24-P1J, 24 V/1.04 A; center-positive; IEC mains cord separate | DigiKey / Mean Well GST25A24-P1J | Price snapshot; availability must be rechecked | Only if coils are 24 V and total current/inrush fits; reuse bench PSU first | https://www.digikey.com/en/products/detail/mean-well-usa-inc/GST25A24-P1J/7703651 | Manufacturer/distributor documentation; no review rating verified Price snapshot 07/10/2026 unless updated below.
E06 | 3 | Borrow | IEC C13 grounded mains cord for candidate PSU | 1 |  | Quote | Matches GST25A24 C14 inlet and local mains outlet | Borrow / approved cord supplier | Check lab stock | Separate from supply; no mains wiring on breadboard |  | Reuse lab cord if compatible
E07 | 5 | Hold | Independent regulated logic supply | 1 |  | Quote | Suitable regulated supply through documented Uno power input; sized for modules | Approved adapter / supply OEM | Design dependent | Final controller must run with laptop removed; never feed 24 V to Uno |  | Choose after total load and grounding plan
P01 | 3 | Hold | Actuation gas regulator + pressure indication + shutoff | 1 |  | Quote | Regulator range/relief and gas type specified by actual actuator manual | Lab gas services / pneumatic OEM | May already exist | Use existing regulated clean dry air/N2 if approved; separate from helium circuit |  | Do not guess cylinder pressure or regulator setting
P02 | 3–4 | Hold | Pneumatic tube, matched fittings, silencers and mounting | 1 |  | Quote | Correct metric/inch OD, pressure rating, port thread and exhaust routing | Valve OEM / pneumatic supplier | Model dependent | Measure actual push-fitting sizes and threads first |  | One installation kit; length/quantities established after layout
P03 | 3 | Hold | Actuation pressure proof switch | 1 |  | Quote | Suitable range; electrical output conditioned for controller | Pneumatic OEM | Model dependent | If pneumatic actuation; detect low air and determine true failure response |  | Needed to distinguish energized coil from available actuation pressure
P04 | 3–5 | Hold | Fail-close pneumatic provision, if actuator requires it | 1 |  | Quote | Stored pressure/close priority or spring return as justified by actual gate design | Gate OEM / reviewed pneumatic circuit | Model dependent | Power-off and air-off must be tested; a double-acting gate can stay open |  | May be unnecessary for verified spring-to-close valve
A01 | 4 | Hold | Automatic roughing vacuum valve, candidate | 1 | $394.00 | $394.00 | KJLC SAV0100PVQF; KF25; spring to close; position indicators; pilot separate | Kurt J. Lesker SAV0100PVQF | Price snapshot; availability must be rechecked | Borrow/reuse actuated valve first; buy only if KF25, conductance and differential-pressure ratings fit | https://www.lesker.com/valves/angle-valves-ss-bellows-sealed/part/sav0100pvqf | No product review rating verified; selected for OEM documentation/support. Price snapshot 07/10/2026 unless updated below.
A02 | 4 | Hold | Automatic vent vacuum valve, provisional candidate | 1 | $394.00 | $394.00 | Same KF25 candidate only if geometry/rating fits; smaller NC vacuum valve may cost less | Kurt J. Lesker SAV0100PVQF | Price snapshot; availability must be rechecked | Do not buy this blindly: vent line size and flow requirement unknown | https://www.lesker.com/valves/angle-valves-ss-bellows-sealed/part/sav0100pvqf | Price is a verified conditional candidate, not a cheapest compatible vent selection Price snapshot 07/10/2026 unless updated below.
A03 | 4 | Hold | 24 V DC 3-way pilots for A01/A02, OEM candidate | 2 | $68.00 | $136.00 | Lesker SE024D3XX; explicitly listed accessory; not a vacuum-wetted valve | Kurt J. Lesker SE024D3XX | Price snapshot; availability must be rechecked | Two only if both listed spring-return pneumatic valves are selected | https://www.lesker.com/valves/angle-valves-ss-bellows-sealed/part/sav0100pvqf | No product review rating verified; selected for OEM documentation/support. Price snapshot 07/10/2026 unless updated below.
A04 | 4 | Hold | Vent metering restriction / needle valve | 1 |  | Quote | Limit admitted gas flow to chamber/pump approved rate | Vacuum fitting / valve OEM | Line dependent | An ON/OFF valve alone does not establish a controlled vent rate |  | May reuse existing manual metering valve after identifying it
A05 | 4 | Hold | Vacuum flange hardware and hose/fittings | 1 |  | Quote | Flange sizes, seals, clamp qty and hose conductance from traced layout | Kurt J. Lesker / matching OEM | Layout dependent | Reuse existing clean compatible hardware; do not assume all connections KF25 |  | Quantity is one installation kit, not one fitting
A06 | 4 | Hold | Manual bypass position proof / removal from active route | 1 |  | Quote | All hand-operated chamber paths must be supervised or excluded | Actual valve OEM / approved mechanical modification | Layout dependent | A handwheel cannot be electronically prevented from moving without a mechanical solution |  | May require replacement rather than a sensor alone
R01 | 3 | Hold | Cryopump cold/ready signal | 1 |  | Quote | Existing supported cryogenic controller relay/status preferred | Cryopump/temperature controller OEM | Model dependent | Compressor ON is not cold/ready; no room-temperature Arduino sensor substitute |  | Need cold-head/thermometer/controller model
R02 | 3–4 | Hold | Rough pump running/ready proof | 1 |  | Quote | Existing controller contact or verified run monitoring; commanded ON is not proof | Pump OEM / reviewed monitoring interface | Model dependent | Pump switching outside current scope; status still required for valve permission |  | Document which pump is selected and other pump isolation
C01 | Prep | Reuse | CTI 8200 cryogenic compressor | 1 | $0.00 | $0.00 | User-reported model; cooling variant and matched services unverified | Owned compressor | User reports owned | Read nameplate and compressor manual before buying water parts |  | Compressor compresses circulating helium, not chamber exhaust
C02 | Prep | Hold | Matched helium supply and return hoses | 1 |  | Quote | OEM-rated self-sealing hose pair and couplings; routing and charge per actual manual | Cryopump OEM | Presence/condition unverified | Two lines; never substitute pneumatic tubing |  | May already be installed; one pair placeholder
C03 | Prep | Hold | Cold-head power cable / correct mains services | 1 |  | Quote | Matched compressor-to-cold-head cable and installed electrical supply | Cryopump/compressor OEM | Presence/ratings unverified | Plug type/voltage/phase/frequency from labels; qualified lab wiring for mains |  | May already exist
C04 | Prep | Hold | Cooling service, only if required | 1 |  | Quote | Water inlet/return, flow/temp/pressure/quality per model; air-cooled unit needs specified clearance | Lab facility / compressor OEM | Cooling variant unknown | Do not buy a chiller until compressor identified |  | Not every compressor needs water
C05 | Prep | Hold | Cryopump regeneration/roughing/purge and relief provisions | 1 |  | Quote | Documented rough connection, vent/purge procedure and relief path | Cryopump OEM / lab vacuum services | Existing provision unknown | Follow actual pump manual; controller must not improvise regeneration |  | May be installed; current software scope excludes regeneration
O04 | 3–4 | Reuse | Agilent IDP-15 dry scroll roughing pump | 1 | $0.00 | $0.00 | Model user-reported; verify inlet valve variant and running-ready signal | Owned | User reports owned | No turbo means no turbo backing-pump requirement on this stand |  | Model/capacity/running proof still needed
O05 | Prep | Reuse | Alcatel 2008A / Varian SD-90 oil pump alternatives | 1 | $0.00 | $0.00 | KJL TSR4MS100QF foreline trap is separate from exhaust mist filtration | Owned | User reports owned | No new oil filter until pump and filter models known | https://www.lesker.com/newweb/traps/traps_technicalnotes.cfm?pgid=0 | Exhaust mist filter, inlet foreline trap and compressor adsorber are different
F01 | 5 | Hold | Secured terminal assembly + labelled cable harness | 1 |  | Quote | Fuse each appropriate circuit; strain relief; field/logic separation; correct conductor ratings | DigiKey / approved terminal and cable supplier | Design dependent | No loose Dupont/breadboard connections for live stand operation |  | Final wire/terminal quantities from pin-level electrical drawing
F02 | 5 | Hold | Enclosure, mounts, fuses, disconnect and close controls | 1 |  | Quote | Accessible close/inhibit; protected terminals; protective bonding as required | Trusted electrical enclosure/component OEM | Design dependent | Sized after hardware is assembled; existing panel may be reused |  | Run / vent / reset / off controls included; manual requests remain interlocked
F03 | 5 | Optional | Additional I2C GPIO expander | 0 | $5.95 | $0.00 | Adafruit 5346 MCP23017; 3/5 V logic, not a 24 V input module | Adafruit 5346 | Price snapshot; availability must be rechecked | Only if Uno plus driver auxiliary GPIO cannot meet verified I/O count | https://www.adafruit.com/product/5346 | No product review rating verified; selected for OEM documentation/support. Price snapshot 07/10/2026 unless updated below.
F04 | 5 | Optional | Soldered prototype PCB, example | 0 | $4.50 | $0.00 | Adafruit 1609; half-size Perma-Proto; use secured terminals or reviewed PCB | Adafruit 1609 | Price snapshot; availability must be rechecked | Example only, not quick-buy recommendation; lab stock or alternate terminal carrier preferred | https://www.adafruit.com/product/1609 | No product review rating verified; selected for OEM documentation/support. Price snapshot 07/10/2026 unless updated below.
F05 | Later | Optional | Front-panel display | 0 |  | Quote | Optional later; laptop readout sufficient now | Not selected | Not required now | Display failure must not be able to stop close/fault processing |  | No LCD/touchscreen purchase in this BOM
B04 | 1 | Optional | 150 mm male-to-male jumpers, 20-pack | 2 | $1.95 | $3.90 | 20 used; 40 suggested on hand. Buy only if owned wires insufficient | Adafruit 1957 | In stock 09/10/2026 | Two packs provide 40 wires; optional subtotal $3.90 | https://www.adafruit.com/product/1957 | OEM listing; no review rating verified; checked 09/10/2026
G07 | 2 | Hold | Shielded RS485 cable + suitable harness terminals | 1 |  | Quote | Length, reference, shield, termination and connector pinout must match installation | Reuse or quote | Not selected | Not a generic straight-through RS232 cable |  | Interface-dependent; obtain cable specification before purchase
G08 | 2 | Hold | Hornet-to-CVG101 OEM sensor cable, if absent | 1 |  | Quote | HB431-1-03F / HB431-1-10F candidate lengths; verify Hornet and Worker Bee compatibility | InstruTech | Quote required | Locate existing cable first; generic DE-9 serial lead is not equivalent | https://www.instrutechinc.com/media/127/download/IGM402%20User%20Manual%20Archived%20000861-115.pdf?v=1 | Archived manual accessories; instrument firmware and cable compatibility must match
G09 | 2 | Hold | 24 V 2.5 A 60 W instrument PSU, if absent | 1 | $19.40 | $19.40 | Conservative Hornet supply candidate; mains cord and instrument harness separate | Mean Well GST60A24-P1J / DigiKey | Listed price rechecked 09/10/2026 | Reuse existing approved supply; barrel adapter is not a direct Hornet connector | https://www.digikey.com/en/products/detail/mean-well-usa-inc/GST60A24-P1J/7703715 | Authorized distributor; no review rating verified; checked 09/10/2026

Sheet: Hardware
HARDWARE IDENTIFICATION • COMPLETE BEFORE FIELD PURCHASES
Reported model names are incorporated; function, terminals and services still need physical verification.
ID | Assembly | Observed evidence | Remaining uncertainty | Exact information needed | User finding / terminal map | Status
H01 | Cryopump | User reports Cryo-Torr 8; earlier photo shows coldhead/helium pair | Model reported; temperature readout and service condition unverified | Cryogenic sensor/readout; readiness threshold; matched services | Cryo-Torr 8 | Model reported; field unverified
H02 | Compressor | User reports CTI 8200 | Cooling variant and services not verified | Full nameplate; air/water variant; mains and matching hoses/cable | CTI 8200 | Model reported; field unverified
H03 | Large cryo gate | IMG_2742: cylinder with C/O fittings, loose-looking leads | Appears pneumatic; not confirmed as-installed or functional | Valve body tag; actuator/pilot tags; C/O definition; air pressure; default state; travel contacts |  | Not verified
H04 | Manual angle valve | IMG_2740 rotated: SA0100MVQF appears legible | Legacy part; current SAV0100MVQF equivalence NOT confirmed | OEM confirms legacy part; port size; which chamber route it serves |  | Not verified
H05 | Other handwheel valves | IMG_2737 and IMG_2739 show hand-operated branches | Route/flow/vent vs roughing not identified | Trace every hose/flange to chamber/pump/gas source; identify bypasses |  | Not verified
H06 | Hornet | User reports Hornet IGM402YFD, 20-28 VDC | Firmware, supply and installed sensor set unverified | INFO firmware; connector labels; existing supply and CVG cable | IGM402YFD, 20-28 VDC | Model reported; field unverified
H07 | Dry scroll pump | User reports Agilent IDP-15 | Inlet-valve variant and running-ready signal unknown | Exact installed variant; route; isolation control; pump readiness | Agilent IDP-15 | Model reported; field unverified
H08 | Oil-sealed pump/filter | User reports Alcatel 2008A, Varian SD-90, KJL TSR4MS100QF | Condition and actual trap/exhaust configuration unverified | Identify inlet foreline trap separately from exhaust mist filter | Alcatel 2008A / Varian SD-90 / KJL trap | Model reported; field unverified
H09 | Actuation gas services | Nitrogen cylinder; DeWalt 175 max PSI and Bostitch 8 gal reported | Regulation and gas compatibility unverified | Regulator/pilot labels; supply pressure proof; vent route separate | Nitrogen + workshop air compressors | Model reported; field unverified
H10 | Cryogenic readiness | No temperature controller identified | Compressor ON cannot substitute for cold proof | Installed cryogenic sensor/controller and ready signal; trip behavior |  | Not verified
H11 | Rough gauge range | Worker Bee CVG101GC possibly available; Hornet IGM402 reported | Sensor presence/function and OEM cable not verified | Locate Worker Bee; verify flange, cable and low-vacuum readings | Possible CVG101GC | Model reported; field unverified
H12 | Cooling services | Depends on compressor cooling variant | Do not infer a water requirement | Air clearance/ambient spec OR water flow/temp/pressure/quality/return route from OEM |  | Not verified
H13 | Helium / cold-head power | Two pump couplings visible | Matched compressor hoses/cable presence unknown | Helium supply/return pair; self-sealing couplings; cold-head cable; OEM charge condition |  | Not verified
H14 | Vacuum topology | Small chamber with cryopump reported | Current as-built diagram incomplete | Three controlled routes cryo/rough/vent; identify regeneration/purge/relief and all manual bypasses |  | Not verified
H15 | Switch and sensor wiring | No field terminal map yet | A wire count does not prove SPST/SPDT use or sensor type | Power-off continuity; label common/throws; identify dry contact vs powered sensor before wiring |  | Not verified
H16 | Pump switching boundary | User says pumps operated elsewhere | Valve-only scope does not remove need for status | Agree who supplies pump running/ready/temp data; never substitute operator assumption in AUTO |  | Not verified
H17 | Power and failure behavior | Uno and breadboard owned | Live fail-close behavior unproven | Actual power loss/air loss response; independent closing provision; output enable default; ratings |  | Not verified

Sheet: Acceptance
DEVELOPMENT PHASES & ACCEPTANCE • WORKING AUTONOMY MUST BE DEMONSTRATED
Five build phases. Prep is inventory only. Host software PASS does not mark physical acceptance as passed.
ID | Phase | Build objective | Essential hardware / boundary | Implementation | Exit criterion | Evidence / date / operator | Result
PREP | Prep | Inventory / identify interfaces (not a build phase) | No field energizing | Photos/tags → manuals → routes → signal list | Every unknown in Hardware mapped; no guessed coil voltage/crossover |  | Not tested
P1 | 1 | LED-only Uno proof | Uno, 3 LEDs, 3 resistors, 3 buttons, 20 male-to-male wires | Manual requests; close priority; conflict rejection; no restart | B01-B12 pass on physical Uno; software record is separate |  | Not tested
P2 | 2 | Live pressure, read-only | Gauge supply/cable; confirmed interface; rough-range sensor if needed | Digital valid/status/stale checks; laptop shows pressure + units | Compare against gauge display at useful ranges; unplug and malformed data inhibit OPEN |  | Not tested
P3 | 3 | One real cryo gate | Identified actuator/pilot/driver; actual closure/open proof; cold proof; independent enable | Request cryo OPEN only with valid pressure/cold/closed vent and no conflicts | Actual travel succeeds; denied request never energizes; fail-close response measured |  | Not tested
P4 | 4 | Controlled roughing and vent routes | Two additional actuated vacuum paths; feedback; pump proof; controlled vent; filament status | All active chamber routes covered; remove/prove manual bypasses | No vent until all pump valves physically closed and filament confirmed OFF; no pump OPEN while vent open |  | Not tested
P5 | 5 | Standalone automatic controller | Secured wiring/enclosure; logic supply; controls; validated field inventory | Deterministic state machine with motion timeouts, fault latch and fresh request after reset | Repeat pumpdown and vent cycles; pass fault matrix; operate with laptop removed |  | Not tested
ID | Phase | Fault / condition | Required response | How to demonstrate | Evidence / date / operator | Result
T01 | 1–5 | Vent and cryo/rough OPEN requested together | Reject all competing OPEN requests; latch fault; closure priority | Use contacts first, actual valves at final acceptance |  | Not tested
T02 | 1–5 | Request held during power return/reset | Remain disarmed; require release, re-arm and fresh request | Power-cycle MCU and field supply separately |  | Not tested
T03 | 2–5 | Gauge unplugged / invalid or stale pressure | Inhibit high-vacuum OPEN; fault active operation per approved close policy | Disconnect serial; inject malformed/out-of-range messages |  | Not tested
T04 | 3–5 | Cryopump cold-ready lost | No new cryo OPEN; command isolation and fault | Use real ready signal with controlled test method |  | Not tested
T05 | 3–5 | Position signal missing or contradictory | Never assume closure; inhibit vent; motion timeout/fault | Remove contact; simulate both endpoints; verify electrical disconnect handling |  | Not tested
T06 | 3–5 | Actuation air lost | Observed response matches designed closing provision; no OPEN enable | Measure real motion, do not infer from coil LED |  | Not tested
T07 | 3–5 | MCU stops / I2C driver stalls | External enable removes OPEN drive; actual actuator closes as designed | I2C outputs can latch; watchdog must not be fed by failed control path |  | Not tested
T08 | 4–5 | Rough pump ready lost | No new rough OPEN; isolate active rough route and fault | Use actual proof source, not software command echo |  | Not tested
T09 | 4–5 | Filament OFF command has no confirmation | Vent remains denied | Check real gauge OFF status and supported control ownership |  | Not tested
T10 | 4–5 | Valve does not reach requested position in time | Latch fault; no next sequence step; never vent on commanded closure alone | Demonstrate with safe controlled test setup |  | Not tested
T11 | 4–5 | Pressure crosses approved operating limit | Trip action and hysteresis match pump/valve OEM limits | Bench inject pressure first; field testing within approved envelope |  | Not tested
T12 | 5 | Laptop/display disconnected or stalled | Uno keeps interlocks/closure running; sequence behavior per selected mode | Standalone supply and physical controls; logs optional |  | Not tested
T13 | 5 | Manual handwheel/bypass changed | Physical bypass cannot defeat intended interlock in final architecture | Remove, lock with appropriate mechanism, or redesign; alarm alone insufficient |  | Not tested
T14 | 5 | Pumpdown + vent cycle repeated | No unintended overlap; thresholds/timeouts documented; return to safe idle | Record pressure, actual valve feedback and timings; review before MAIZE transfer |  | Not tested
