harshddes/VacuumSystem-Arduino/development/bench-prep/verification/physical-test-log.csv

test_id | date | operator | firmware_commit | wiring_revision | observation | measurement | status
L01 |  |  |  |  |  |  | NOT TESTED
L02 |  |  |  |  |  |  | NOT TESTED
L03 |  |  |  |  |  |  | NOT TESTED
L04 |  |  |  |  |  |  | NOT TESTED
L05 |  |  |  |  |  |  | NOT TESTED
L06 |  |  |  |  |  |  | NOT TESTED
R01 |  |  |  |  |  |  | NOT TESTED
G01 |  |  |  |  |  |  | NOT TESTED
G02 |  |  |  |  |  |  | NOT TESTED
G03 |  |  |  |  |  |  | NOT TESTED
G04 |  |  |  |  |  |  | NOT TESTED
G05 |  |  |  |  |  |  | NOT TESTED
G06 |  |  |  |  |  |  | NOT TESTED
G07 |  |  |  |  |  |  | NOT TESTED
G08 |  |  |  |  |  |  | NOT TESTED
G09 |  |  |  |  |  |  | NOT TESTED
G10 |  |  |  |  |  |  | NOT TESTED
G11 |  |  |  |  |  |  | NOT TESTED
G12 |  |  |  |  |  |  | NOT TESTED
