harshddes/VacuumSystem-Arduino/development/verification/host-test-results.txt

Revision: 2026-10-09
Executed: 2026-10-09T19:00:29.349255+00:00
Command: bash development/tests/run_tests.sh
Compiler: g++ (Ubuntu 13.3.0-6ubuntu2~24.04) 13.3.0

PASS: 519 core scenarios; no hardware tested.
PASS: sketch host-stub syntax check. AVR target compilation and physical testing remain pending.

Arduino IDE / AVR target build: NOT RUN
Physical breadboard, sensors and valves: NOT TESTED
