harshddes/VacuumSystem-Arduino/development/verification/test-log.csv

test_id | phase | requirement | date | operator | firmware_commit | wiring_revision | configuration_record | initial_conditions | observed_result | measured_timing | status | evidence_path
B01 | 1 | R01 |  |  |  |  |  |  |  |  | NOT TESTED
B02 | 1 | R01 |  |  |  |  |  |  |  |  | NOT TESTED
B03 | 1 | R03/R07 |  |  |  |  |  |  |  |  | NOT TESTED
B04 | 1 | R03/R09 |  |  |  |  |  |  |  |  | NOT TESTED
B05 | 1 | R07 |  |  |  |  |  |  |  |  | NOT TESTED
B06 | 1 | R04 |  |  |  |  |  |  |  |  | NOT TESTED
B07 | 1 | R04/R09 |  |  |  |  |  |  |  |  | NOT TESTED
B08 | 1 | R02 |  |  |  |  |  |  |  |  | NOT TESTED
B09 | 1 | R01 |  |  |  |  |  |  |  |  | NOT TESTED
B10 | 1 | R07 |  |  |  |  |  |  |  |  | NOT TESTED
B11 | 1 | R01 |  |  |  |  |  |  |  |  | NOT TESTED
B12 | 1 | R04 |  |  |  |  |  |  |  |  | NOT TESTED
P01 | 2 | R12 |  |  |  |  |  |  |  |  | NOT TESTED
P02 | 2 | R03/R10 |  |  |  |  |  |  |  |  | NOT TESTED
P03 | 2 | R09 |  |  |  |  |  |  |  |  | NOT TESTED
V01 | 3 | R12 |  |  |  |  |  |  |  |  | NOT TESTED
V02 | 3 | R09 |  |  |  |  |  |  |  |  | NOT TESTED
V03 | 3 | R03 |  |  |  |  |  |  |  |  | NOT TESTED
V04 | 3 | R01/R11 |  |  |  |  |  |  |  |  | NOT TESTED
S01 | 4 | R13 |  |  |  |  |  |  |  |  | NOT TESTED
S02 | 4 | R04 |  |  |  |  |  |  |  |  | NOT TESTED
S03 | 4 | R05 |  |  |  |  |  |  |  |  | NOT TESTED
S04 | 4 | R07 |  |  |  |  |  |  |  |  | NOT TESTED
S05 | 4 | R14 |  |  |  |  |  |  |  |  | NOT TESTED
A01 | 5 | R08 |  |  |  |  |  |  |  |  | NOT TESTED
A02 | 5 | R03-R05/R08 |  |  |  |  |  |  |  |  | NOT TESTED
A03 | 5 | R09 |  |  |  |  |  |  |  |  | NOT TESTED
A04 | 5 | R10/R11 |  |  |  |  |  |  |  |  | NOT TESTED
A05 | 5 | R01/R11 |  |  |  |  |  |  |  |  | NOT TESTED
A06 | 5 | R12/R14 |  |  |  |  |  |  |  |  | NOT TESTED
