harshddes/VacuumSystem-Arduino/development/CHANGELOG.md

# Development baseline history

## 2026-10-09

- Established a dedicated development folder without changing existing Uno references or pin-check code.
- Set Arduino Uno R3 as the current board; replaced older Nano assumptions.
- Defined five build phases, with the exact 20-wire LED exercise first.
- Incorporated reported CTI 8200, Cryo-Torr 8, IDP-15, Hornet IGM402YFD and optional equipment.
- Separated verified bench software from unimplemented field interfaces and automatic sequences.
- Included requirements, procurement, schematics, code, host tests and physical acceptance templates.
- Preserved unresolved field terminal assignments and operating limits as explicit commissioning items.

Future revisions should record the component/firmware evidence that resolves each open item and the acceptance tests actually performed.
