harshddes/VacuumSystem-Arduino/development/kicad/maize-controller/maize-controller.pdf

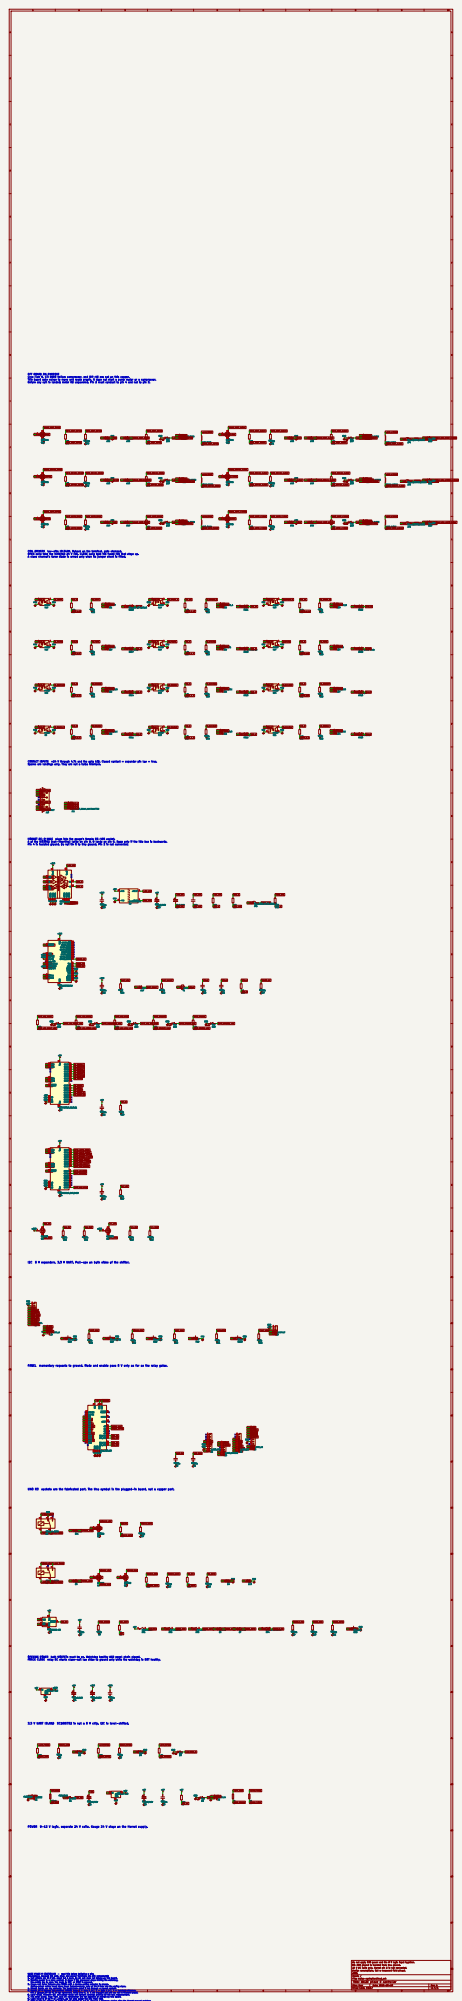
[picture p3: page 1]

OFF BOARD ON PURPOSE
Cryo-Torr 8, CTI 8200 helium compressor, and IDP-15 are not on this copper.
This board asks valves to move and reads proofs. It does not start a pump motor or a compressor.
Before any coil is landed: meter K2 unpowered. Pin 2 must conduct to pin 4 and not to pin 3.

COIL DRIVERS low-side IRLZ44N, flyback on the terminal, gate clamped.
OPEN coils take the inhibited 24 V rail. CLOSE coils take the fused rail that stays up.
A close channel's force diode is armed only when its jumper shunt is fitted.

CONTACT INPUTS +24 V through 4.7k and the opto LED. Closed contact = expander pin low = true.
Spares are landings only. They are not a turbo interlock.

HORNET DE-9 MALE plugs into the gauge's female RS-485 socket.
A of the ISO3082 (non-inverting) lands on pin 9. B lands on pin 6. Swap only if the idle bus is backwards.
Pin 4 is isolated ground. Do not tie it to Uno ground. Pin 2 is not connected.
13 GND2 15 Vcc2 16 U7

TXB 23 RXB 24 GPIO4/DSRA 25 GPIO5/DTRA 26 GPIO6/CDA 27 GPIO7/RIA 28 GND

TXB 23 RXB 24 GPIO4/DSRA 25 GPIO5/DTRA 26 GPIO6/CDA 27 GPIO7/RIA 28 U6

I2C 5 V expanders, 3.3 V UART. Pull-ups on both sides of the shifter.

PANEL momentary requests to ground. Mode and enable pass 5 V only as far as the relay gates.

UNO R3 sockets are the fabricated part. The Uno symbol is the plugged-in board, not a copper part.

OPENING POWER both MOSFETs must be on. Watchdog healthy AND panel chain closed.
FORCE CLOSE relay NC shorts close-coil low sides to ground only while the watchdog is NOT healthy.

3.3 V UART ISLAND SC16IS752 is not a 5 V chip. I2C is level-shifted.

POWER 9-12 V logic, separate 24 V coils. Gauge 24 V stays on the Hornet supply.

Do not apply USB power and the 9 V logic input together.
RS-485 ground is isolated from Uno ground.
24 V DC coils only. Hornet pin 2 is not connected.
Design assumptions. Not a measured field pinout.
PPML
Sheet: /
File: maize-controller.kicad_sch
Title: MAIZE phase 5 controller

MAIZE PHASE 5 CONTROLLER — read this before believing a wire

Size: User | Rev: A
KiCad E.D.A. 10.0.7 | Id: 1/1
