harshddes/VacuumSystem-Arduino/development/kicad/maize-controller/maize-controller.kicad_pcb

## KiCad design development/kicad/maize-controller/maize-controller.kicad_pcb (2026-10-24)

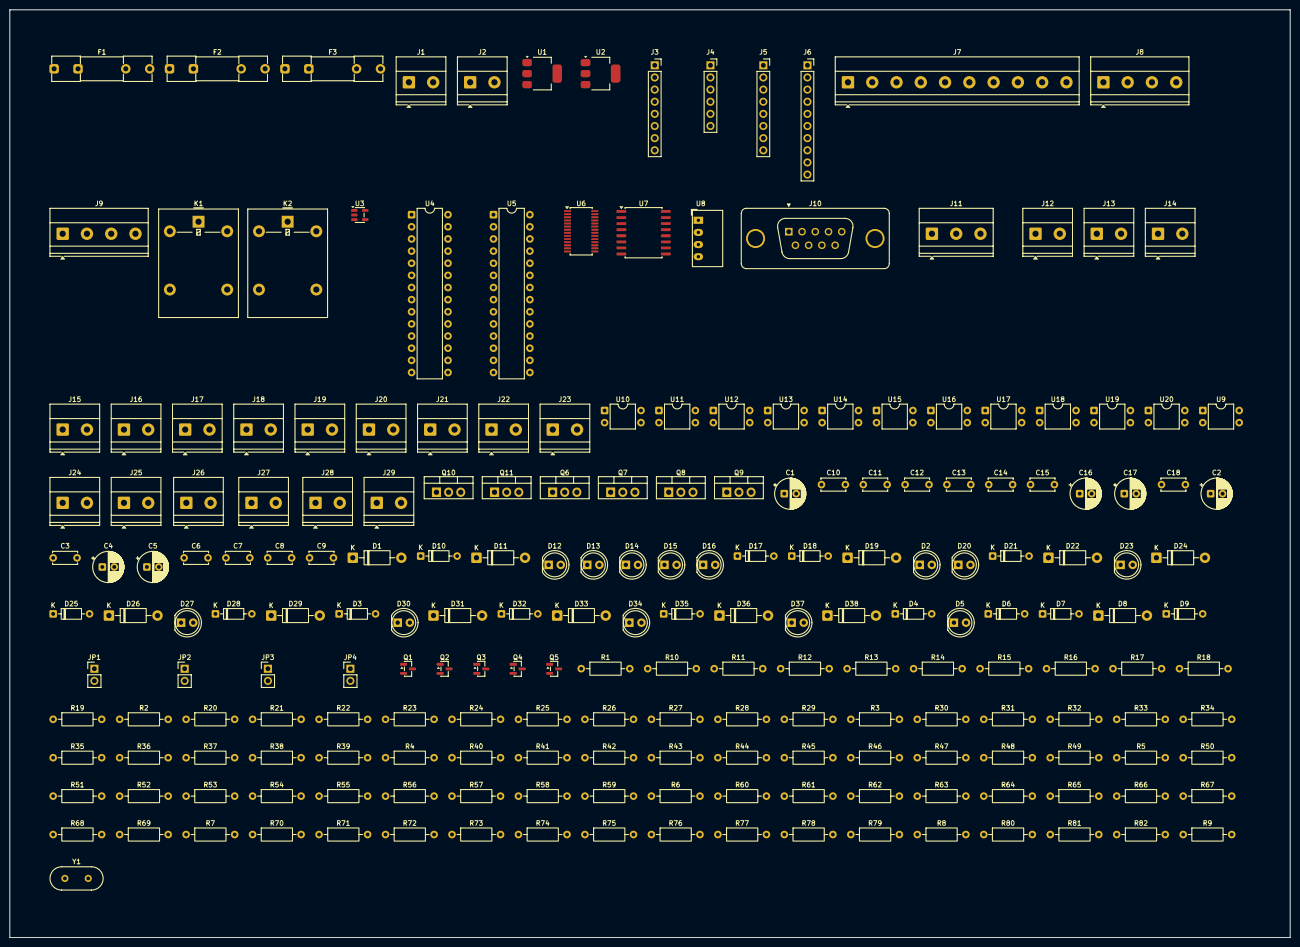
[picture p4: board maize-controller.kicad_pcb from above]

Board: 2 copper layers, 267.9 x 194.1 mm, 208 parts (0 on the bottom side), 130 nets, no tracks yet.

Parts:
C1: 10uF/25V; CP_Radial_D6.3mm_P2.50mm
C2: 22uF/16V; CP_Radial_D6.3mm_P2.50mm
C3, C6, C7, C8, C9, C10, C11, C12, C15, C18: 100n; C_Disc_D5.0mm_W2.5mm_P5.00mm
C4, C16, C17: 10uF/16V; CP_Radial_D6.3mm_P2.50mm
C5: 22uF/10V; CP_Radial_D6.3mm_P2.50mm
C13, C14: 22p; C_Disc_D5.0mm_W2.5mm_P5.00mm
D1, D8, D11, D19, D22, D24, D26, D29, D31, D33, D36, D38: 1N4007; D_DO-41_SOD81_P10.16mm_Horizontal
D2, D5, D12, D13, D14, D15, D16, D20, D23, D27, D30, D34, D37: LED; LED_D5.0mm
D3, D4: 5.1V; D_DO-35_SOD27_P7.62mm_Horizontal
D6, D7, D17: 1N4148; D_DO-35_SOD27_P7.62mm_Horizontal
D9, D10, D18, D21, D25, D28, D32, D35: 12V; D_DO-35_SOD27_P7.62mm_Horizontal
F1: 500mA; Fuseholder_Clip-5x20mm_Littelfuse_111_Inline_P20.00x5.00mm_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
F2: 3A; Fuseholder_Clip-5x20mm_Littelfuse_111_Inline_P20.00x5.00mm_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
F3: 2A; Fuseholder_Clip-5x20mm_Littelfuse_111_Inline_P20.00x5.00mm_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
J1: J_LOGIC; TerminalBlock_Phoenix_MKDS-1,5-2-5.08_1x02_P5.08mm_Horizont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
J2: J_COIL24; TerminalBlock_Phoenix_MKDS-1,5-2-5.08_1x02_P5.08mm_Horizont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
J3: J_UNO_PWR; PinSocket_1x08_P2.54mm_Vertical
J4: J_UNO_ANALOG; PinSocket_1x06_P2.54mm_Vertical
J5: J_UNO_D0; PinSocket_1x08_P2.54mm_Vertical
J6: J_UNO_D8; PinSocket_1x10_P2.54mm_Vertical
J7: J_PANEL; TerminalBlock_Phoenix_MKDS-1,5-10-5.08_1x10_P5.08mm_Horizon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
J8: J_PANEL_B; TerminalBlock_Phoenix_MKDS-1,5-4-5.08_1x04_P5.08mm_Horizont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
J9: J_DISPLAY; TerminalBlock_Phoenix_MKDS-1,5-4-5.08_1x04_P5.08mm_Horizont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
J10: J_HORNET; DSUB-9_Pins_Vertical_P2.77x2.84mm_MountingHoles
J11: J_HORNET_RELAY_UNCOMMITTED; TerminalBlock_Phoenix_MKDS-1,5-3-5.08_1x03_P5.08mm_Horizont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
J12: J_ZS101C; TerminalBlock_Phoenix_MKDS-1,5-2-5.08_1x02_P5.08mm_Horizont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
J13: J_ZS101O; TerminalBlock_Phoenix_MKDS-1,5-2-5.08_1x02_P5.08mm_Horizont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
J14: J_ZS102C; TerminalBlock_Phoenix_MKDS-1,5-2-5.08_1x02_P5.08mm_Horizont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
J15: J_ZS102O; TerminalBlock_Phoenix_MKDS-1,5-2-5.08_1x02_P5.08mm_Horizont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
J16: J_ZS103C; TerminalBlock_Phoenix_MKDS-1,5-2-5.08_1x02_P5.08mm_Horizont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
J17: J_ZS103O; TerminalBlock_Phoenix_MKDS-1,5-2-5.08_1x02_P5.08mm_Horizont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
J18: J_TI101; TerminalBlock_Phoenix_MKDS-1,5-2-5.08_1x02_P5.08mm_Horizont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
J19: J_PS101; TerminalBlock_Phoenix_MKDS-1,5-2-5.08_1x02_P5.08mm_Horizont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
J20: J_P102; TerminalBlock_Phoenix_MKDS-1,5-2-5.08_1x02_P5.08mm_Horizont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
J21: J_IGOFF; TerminalBlock_Phoenix_MKDS-1,5-2-5.08_1x02_P5.08mm_Horizont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
J22: J_SPARE_A; TerminalBlock_Phoenix_MKDS-1,5-2-5.08_1x02_P5.08mm_Horizont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
J23: J_SPARE_B; TerminalBlock_Phoenix_MKDS-1,5-2-5.08_1x02_P5.08mm_Horizont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
J24: J_CRYO_OPEN; TerminalBlock_Phoenix_MKDS-1,5-2-5.08_1x02_P5.08mm_Horizont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
J25: J_CRYO_CLOSE; TerminalBlock_Phoenix_MKDS-1,5-2-5.08_1x02_P5.08mm_Horizont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
J26: J_ROUGH_OPEN; TerminalBlock_Phoenix_MKDS-1,5-2-5.08_1x02_P5.08mm_Horizont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
J27: J_ROUGH_CLOSE; TerminalBlock_Phoenix_MKDS-1,5-2-5.08_1x02_P5.08mm_Horizont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
J28: J_VENT_OPEN; TerminalBlock_Phoenix_MKDS-1,5-2-5.08_1x02_P5.08mm_Horizont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
J29: J_VENT_CLOSE; TerminalBlock_Phoenix_MKDS-1,5-2-5.08_1x02_P5.08mm_Horizont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
JP1: TERM_120_FIT_TO_ENABLE; PinHeader_1x02_P2.54mm_Vertical
JP2: FORCE_CRYO_CLOSE; PinHeader_1x02_P2.54mm_Vertical
JP3: FORCE_ROUGH_CLOSE; PinHeader_1x02_P2.54mm_Vertical
JP4: FORCE_VENT_CLOSE; PinHeader_1x02_P2.54mm_Vertical
K1, K2: G5LE-1-DC24; Relay_SPDT_Omron-G5LE-1
Q1, Q2, Q3: 2N7002; SOT-23
Q4, Q5: BSS138; SOT-23
Q6, Q7, Q8, Q9, Q10, Q11: IRLZ44N; TO-220-3_Vertical
R1, R29, R30, R31, R32, R33, R67, R70, R73, R76, R79, R82: 2.2k; R_Axial_DIN0207_L6.3mm_D2.5mm_P10.16mm_Horizontal
R2, R4, R9, R10, R11, R13, R15, R17, R37, R66, R69, R72, R75, R78, R81: 100k; R_Axial_DIN0207_L6.3mm_D2.5mm_P10.16mm_Horizontal
R3, R5: 15k; R_Axial_DIN0207_L6.3mm_D2.5mm_P10.16mm_Horizontal
R6, R23, R24, R25, R26, R41, R43, R45, R47, R49, R51, R53, R55, R57, R59, R61, R63: 4.7k; R_Axial_DIN0207_L6.3mm_D2.5mm_P10.16mm_Horizontal
R7, R18, R19, R20, R21, R22, R27, R28, R35, R42, R44, R46, R48, R50, R52, R54, R56, R58, R60, R62, R64: 10k; R_Axial_DIN0207_L6.3mm_D2.5mm_P10.16mm_Horizontal
R8, R12, R14, R16, R34: 1k; R_Axial_DIN0207_L6.3mm_D2.5mm_P10.16mm_Horizontal
R36: 1M; R_Axial_DIN0207_L6.3mm_D2.5mm_P10.16mm_Horizontal
R38, R39: 680; R_Axial_DIN0207_L6.3mm_D2.5mm_P10.16mm_Horizontal
R40: 120; R_Axial_DIN0207_L6.3mm_D2.5mm_P10.16mm_Horizontal
R65, R68, R71, R74, R77, R80: 100; R_Axial_DIN0207_L6.3mm_D2.5mm_P10.16mm_Horizontal
U1: AMS1117-5.0; SOT-223-3_TabPin2
U2: AMS1117-3.3; SOT-223-3_TabPin2
U3: TPS3823-33; SOT-23-5
U4: MCP23017_OUT_0x20; DIP-28_W7.62mm
U5: MCP23017_IN_0x21; DIP-28_W7.62mm
U6: SC16IS752IPW; TSSOP-28_4.4x9.7mm_P0.65mm
U7: ISO3082DW; SOIC-16W_7.5x10.3mm_P1.27mm
U8: CRE1S0505SC; Converter_DCDC_Murata_CRE1xxxxxxSC_THT
U9, U10, U11, U12, U13, U14, U15, U16, U17, U18, U19, U20: PC817; DIP-4_W7.62mm
Y1: 1.8432MHz; Crystal_HC49-U_Vertical

Connections:
+3V3: C5.1, C6.1, C12.1, C15.1, Q4.1, Q5.1, R24.2, R26.2, R34.2, R35.2, U2.2, U6.8, U6.9, U6.10, U6.11, U7.1
+5V: C2.1, C3.1, C4.1, C7.1, C10.1, C11.1, C16.1, J7.2, J9.2, R1.1, R7.2, R18.2, R19.2, R20.2, R21.2, R22.2, R23.2, R25.2, R27.2, R28.2, R42.2, R44.2, R46.2, R48.2, R50.2, R52.2, R54.2, R56.2, R58.2, R60.2, R62.2, R64.2, U1.2, U2.3, U3.5, U4.9, U5.9, U5.15, U8.2
+5V_ISO: C17.1, C18.1, R38.1, U7.16, U8.4
+9V: C1.1, D1.1, J3.8, U1.3
+9V_RAW: F1.1, J1.1
+9V_SW: D1.2, F1.2
+24V_CLOSE: D22.1, D29.1, D36.1, F3.2, J25.1, J27.1, J29.1
+24V_FUSED: D8.1, D11.1, F2.2, F3.1, J12.1, J13.1, J14.1, J15.1, J16.1, J17.1, J18.1, J19.1, J20.1, J21.1, J22.1, J23.1, K1.1, K1.2, K2.1, R2.1
+24V_OPEN: D19.1, D26.1, D33.1, J24.1, J26.1, J28.1, K1.3, R4.1, R6.1
+24V_RAW: F2.1, J2.1
ARM_BTN: J6.1, J8.2, R21.1
BUS_A: J10.9, JP1.1, R38.2, U7.12
BUS_B: J10.6, R39.1, R40.2, U7.13
CRYO_REQ: J5.6, J7.9, R18.1
DRAIN_CRYO_CLOSE: D22.2, J25.2, JP2.1, Q7.2
DRAIN_CRYO_OPEN: D19.2, J24.2, Q6.2
DRAIN_ROUGH_CLOSE: D29.2, J27.2, JP3.1, Q9.2
DRAIN_ROUGH_OPEN: D26.2, J26.2, Q8.2
DRAIN_VENT_CLOSE: D36.2, J29.2, JP4.1, Q11.2
DRAIN_VENT_OPEN: D33.2, J28.2, Q10.2
ENABLE_GATE: D9.1, Q1.1, R12.2, R13.1
ENABLE_RAW: D6.1, D7.1, J7.6
ENABLE_SW: J7.7, R9.1, R12.1
FORCE_BUS: D24.1, D31.1, D38.1, K2.2
FORCE_GATE: Q3.1, R16.2, R17.1
FORCE_MID_CRYO_CLOSE: D24.2, JP2.2
FORCE_MID_ROUGH_CLOSE: D31.2, JP3.2
FORCE_MID_VENT_CLOSE: D38.2, JP4.2
GATE_CRYO_CLOSE: D21.1, Q7.1, R68.2, R69.1
GATE_CRYO_OPEN: D18.1, Q6.1, R65.2, R66.1
GATE_ROUGH_CLOSE: D28.1, Q9.1, R74.2, R75.1
GATE_ROUGH_OPEN: D25.1, Q8.1, R71.2, R72.1
GATE_VENT_CLOSE: D35.1, Q11.1, R80.2, R81.1
GATE_VENT_OPEN: D32.1, Q10.1, R77.2, R78.1
GND: C1.2, C2.2, C3.2, C4.2, C5.2, C6.2, C7.2, C8.2, C9.2, C10.2, C11.2, C12.2, C13.2, C14.2, C15.2, C16.2, D2.1, D3.2, D4.2, D5.1, D9.2, D10.2, D12.1, D13.1, D14.1, D15.1, D16.1, D18.2, D20.1, D21.2, D23.1, D25.2, D27.1, D28.2, D30.1, D32.2, D34.1, D35.2, D37.1, J1.2, J2.2, J3.6, J3.7, J6.7, J7.1, J8.4, J9.1, K2.4, Q2.2, Q3.2, Q6.3, Q7.3, Q8.3, Q9.3, Q10.3, Q11.3, R3.2, R5.2, R9.2, R10.2, R11.2, R13.2, R15.2, R17.2, R37.2, R66.2, R69.2, R72.2, R75.2, R78.2, R81.2, U1.1, U2.1, U3.2, U4.10, U4.15, U4.16, U4.17, U5.10, U5.16, U5.17, U6.2, U6.16, U6.22, U6.24, U7.2, U7.7, U7.8, U8.1, U9.2, U9.3, U10.2, U10.3, U11.2, U11.3, U12.2, U12.3, U13.2, U13.3, U14.2, U14.3, U15.2, U15.3, U16.2, U16.3, U17.2, U17.3, U18.2, U18.3, U19.2, U19.3, U20.2, U20.3
GND_ISO: C17.2, C18.2, J10.4, R39.2, U7.9, U7.10, U7.15, U8.3
GPIO_CRYO_CLOSE: R68.1, R70.1, U4.22
GPIO_CRYO_OPEN: R65.1, R67.1, U4.21
GPIO_LED_ARMED: R30.1, U4.28
GPIO_LED_ARMED_LED: D13.2, R30.2
GPIO_LED_FAULT: R29.1, U4.27
GPIO_LED_FAULT_LED: D12.2, R29.2
GPIO_LED_SEQ: R31.1, U4.8
GPIO_LED_SEQ_LED: D14.2, R31.2
GPIO_ROUGH_CLOSE: R74.1, R76.1, U4.24
GPIO_ROUGH_OPEN: R71.1, R73.1, U4.23
GPIO_SPARE0: R32.1, U4.1
GPIO_SPARE0_LED: D15.2, R32.2
GPIO_SPARE1: R33.1, U4.2
GPIO_SPARE1_LED: D16.2, R33.2
GPIO_VENT_CLOSE: R80.1, R82.1, U4.26
GPIO_VENT_OPEN: R77.1, R79.1, U4.25
HORNET_RLY_1: J10.1, J11.1
HORNET_RLY_5: J10.5, J11.2
HORNET_RLY_7: J10.7, J11.3
INT_IN: J5.3, R28.1, U5.19, U5.20
IN_IGOFF: R60.1, U5.3, U18.4
IN_P102: R58.1, U5.2, U17.4
IN_PS101: R56.1, U5.1, U16.4
IN_SPARE_A: R62.1, U5.4, U19.4
IN_SPARE_B: R64.1, U5.5, U20.4
IN_TI101: R54.1, U5.27, U15.4
IN_ZS101C: R42.1, U5.21, U9.4
IN_ZS101O: R44.1, U5.22, U10.4
IN_ZS102C: R46.1, U5.23, U11.4
IN_ZS102O: R48.1, U5.24, U12.4
IN_ZS103C: R50.1, U5.25, U13.4
IN_ZS103O: R52.1, U5.26, U14.4
KFORCE_LOW: D11.2, K2.5, Q3.3
KOPEN_LOW: D8.2, K1.5, Q1.3
KOPEN_MID: Q1.2, Q2.3
LED_5V: D2.2, R1.2
LED_CRYO_CLOSE: D23.2, R70.2
LED_CRYO_OPEN: D20.2, R67.2
LED_OPEN_A: D5.2, R6.2
LED_ROUGH_CLOSE: D30.2, R76.2
LED_ROUGH_OPEN: D27.2, R73.2
LED_VENT_CLOSE: D37.2, R82.2
LED_VENT_OPEN: D34.2, R79.2
MODE_AUTO: D7.2, J6.5, J7.5, R11.1
MODE_MAN: D6.2, J6.4, J7.4, R10.1
OPTO_A_0: R41.2, U9.1
OPTO_A_1: R43.2, U10.1
OPTO_A_2: R45.2, U11.1
OPTO_A_3: R47.2, U12.1
OPTO_A_4: R49.2, U13.1
OPTO_A_5: R51.2, U14.1
OPTO_A_6: R53.2, U15.1
OPTO_A_7: R55.2, U16.1
OPTO_A_8: R57.2, U17.1
OPTO_A_9: R59.2, U18.1
OPTO_A_10: R61.2, U19.1
OPTO_A_11: R63.2, U20.1
OUT_INT: R27.1, U4.19, U4.20
ROUGH_REQ: J5.7, J7.10, R19.1
RS485_DE: R37.1, U6.18, U7.4, U7.5
SCL_3V3: Q5.2, R26.1, U6.13
SCL_5V: J4.6, J6.10, J9.4, Q5.3, R25.1, U4.12, U5.12
SDA_3V3: Q4.2, R24.1, U6.14
SDA_5V: J4.5, J6.9, J9.3, Q4.3, R23.1, U4.13, U5.13
SENSE_24V: D3.1, J4.1, R2.2, R3.1
SENSE_OPEN: D4.1, J4.2, R4.2, R5.1
SIG_0: J12.2, R41.1
SIG_1: J13.2, R43.1
SIG_2: J14.2, R45.1
SIG_3: J15.2, R47.1
SIG_4: J16.2, R49.1
SIG_5: J17.2, R51.1
SIG_6: J18.2, R53.1
SIG_7: J19.2, R55.1
SIG_8: J20.2, R57.1
SIG_9: J21.2, R59.1
SIG_10: J22.2, R61.1
SIG_11: J23.2, R63.1
START_BTN: J6.3, J8.3, R22.1
STOP_NODE: J6.2, J7.8, R7.1, U3.3
TERM_MID: JP1.2, R40.1
UART_IRQ: J5.4, R34.1, U6.15
UART_RESET: D17.2, R35.1, U6.5
UART_RX: U6.4, U7.3
UART_TX: U6.3, U7.6
UNO_3V3: C9.1, J3.4
UNO_5V: C8.1, J3.5
VENT_REQ: J5.8, J8.1, R20.1
WDI: R8.2, U3.4
WDI_UNO: J5.5, R8.1
WD_GATE: D10.1, Q2.1, R14.2, R15.1
WD_OK: D17.1, R14.1, R16.1, U3.1, U4.18, U5.18
XTAL1: C13.1, R36.1, U6.6, Y1.1
XTAL2: C14.1, R36.2, U6.7, Y1.2
