harshddes/VacuumSystem-Arduino/development/bench-prep/kicad/day1-loopback/day1-loopback.kicad_sch

## KiCad design development/bench-prep/kicad/day1-loopback/day1-loopback.kicad_sch (2026-10-20)

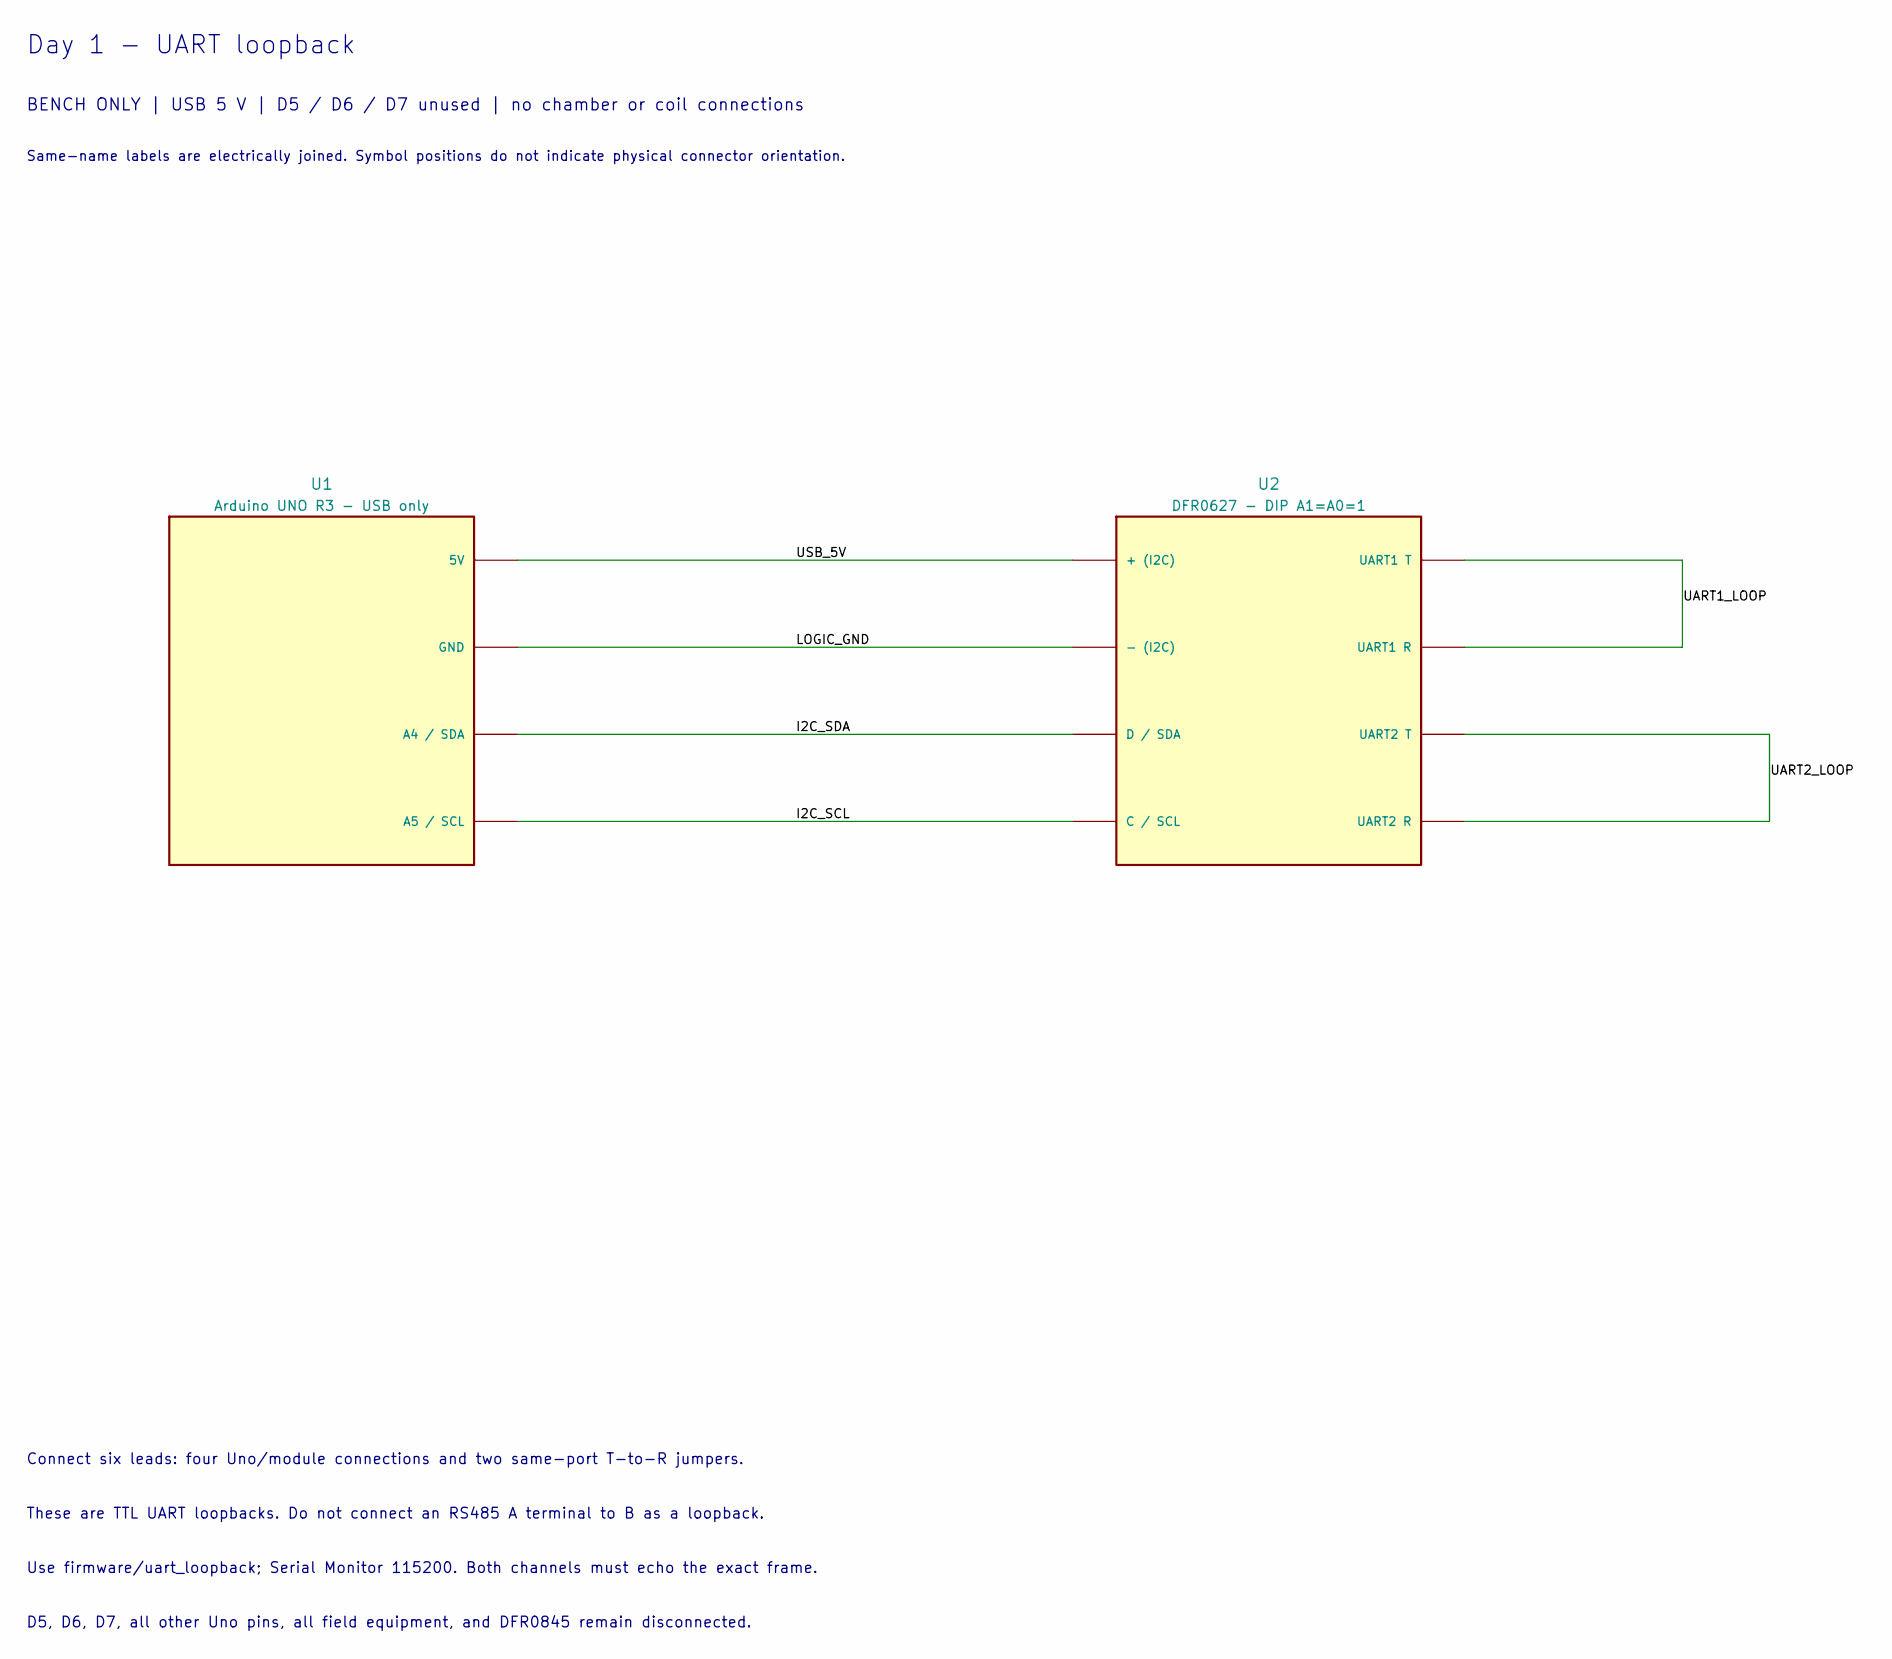
[picture p9: schematic day1-loopback.kicad_sch]

Parts:
U1: Arduino UNO R3 - USB only
U2: DFR0627 - DIP A1=A0=1

Connections:
I2C_SCL: U1.A5 (A5 / SCL), U2.SCL (C / SCL)
I2C_SDA: U1.A4 (A4 / SDA), U2.SDA (D / SDA)
LOGIC_GND: U1.GND, U2.MINUS (- (I2C))
UART1_LOOP: U2.R1 (UART1 R), U2.T1 (UART1 T)
UART2_LOOP: U2.R2 (UART2 R), U2.T2 (UART2 T)
USB_5V: U1.5V, U2.PLUS (+ (I2C))

Notes on the sheet:
Day 1 - UART loopback
BENCH ONLY | USB 5 V | D5 / D6 / D7 unused | no chamber or coil connections
Same-name labels are electrically joined. Symbol positions do not indicate physical connector orientation.
Connect six leads: four Uno/module connections and two same-port T-to-R jumpers.
These are TTL UART loopbacks. Do not connect an RS485 A terminal to B as a loopback.
Use firmware/uart_loopback; Serial Monitor 115200. Both channels must echo the exact frame.
D5, D6, D7, all other Uno pins, all field equipment, and DFR0845 remain disconnected.
