harshddes/VacuumSystem-Arduino/development/bench-prep/kicad/day1-rs485-logic/day1-rs485-logic.kicad_sch

## KiCad design development/bench-prep/kicad/day1-rs485-logic/day1-rs485-logic.kicad_sch (2026-10-20)

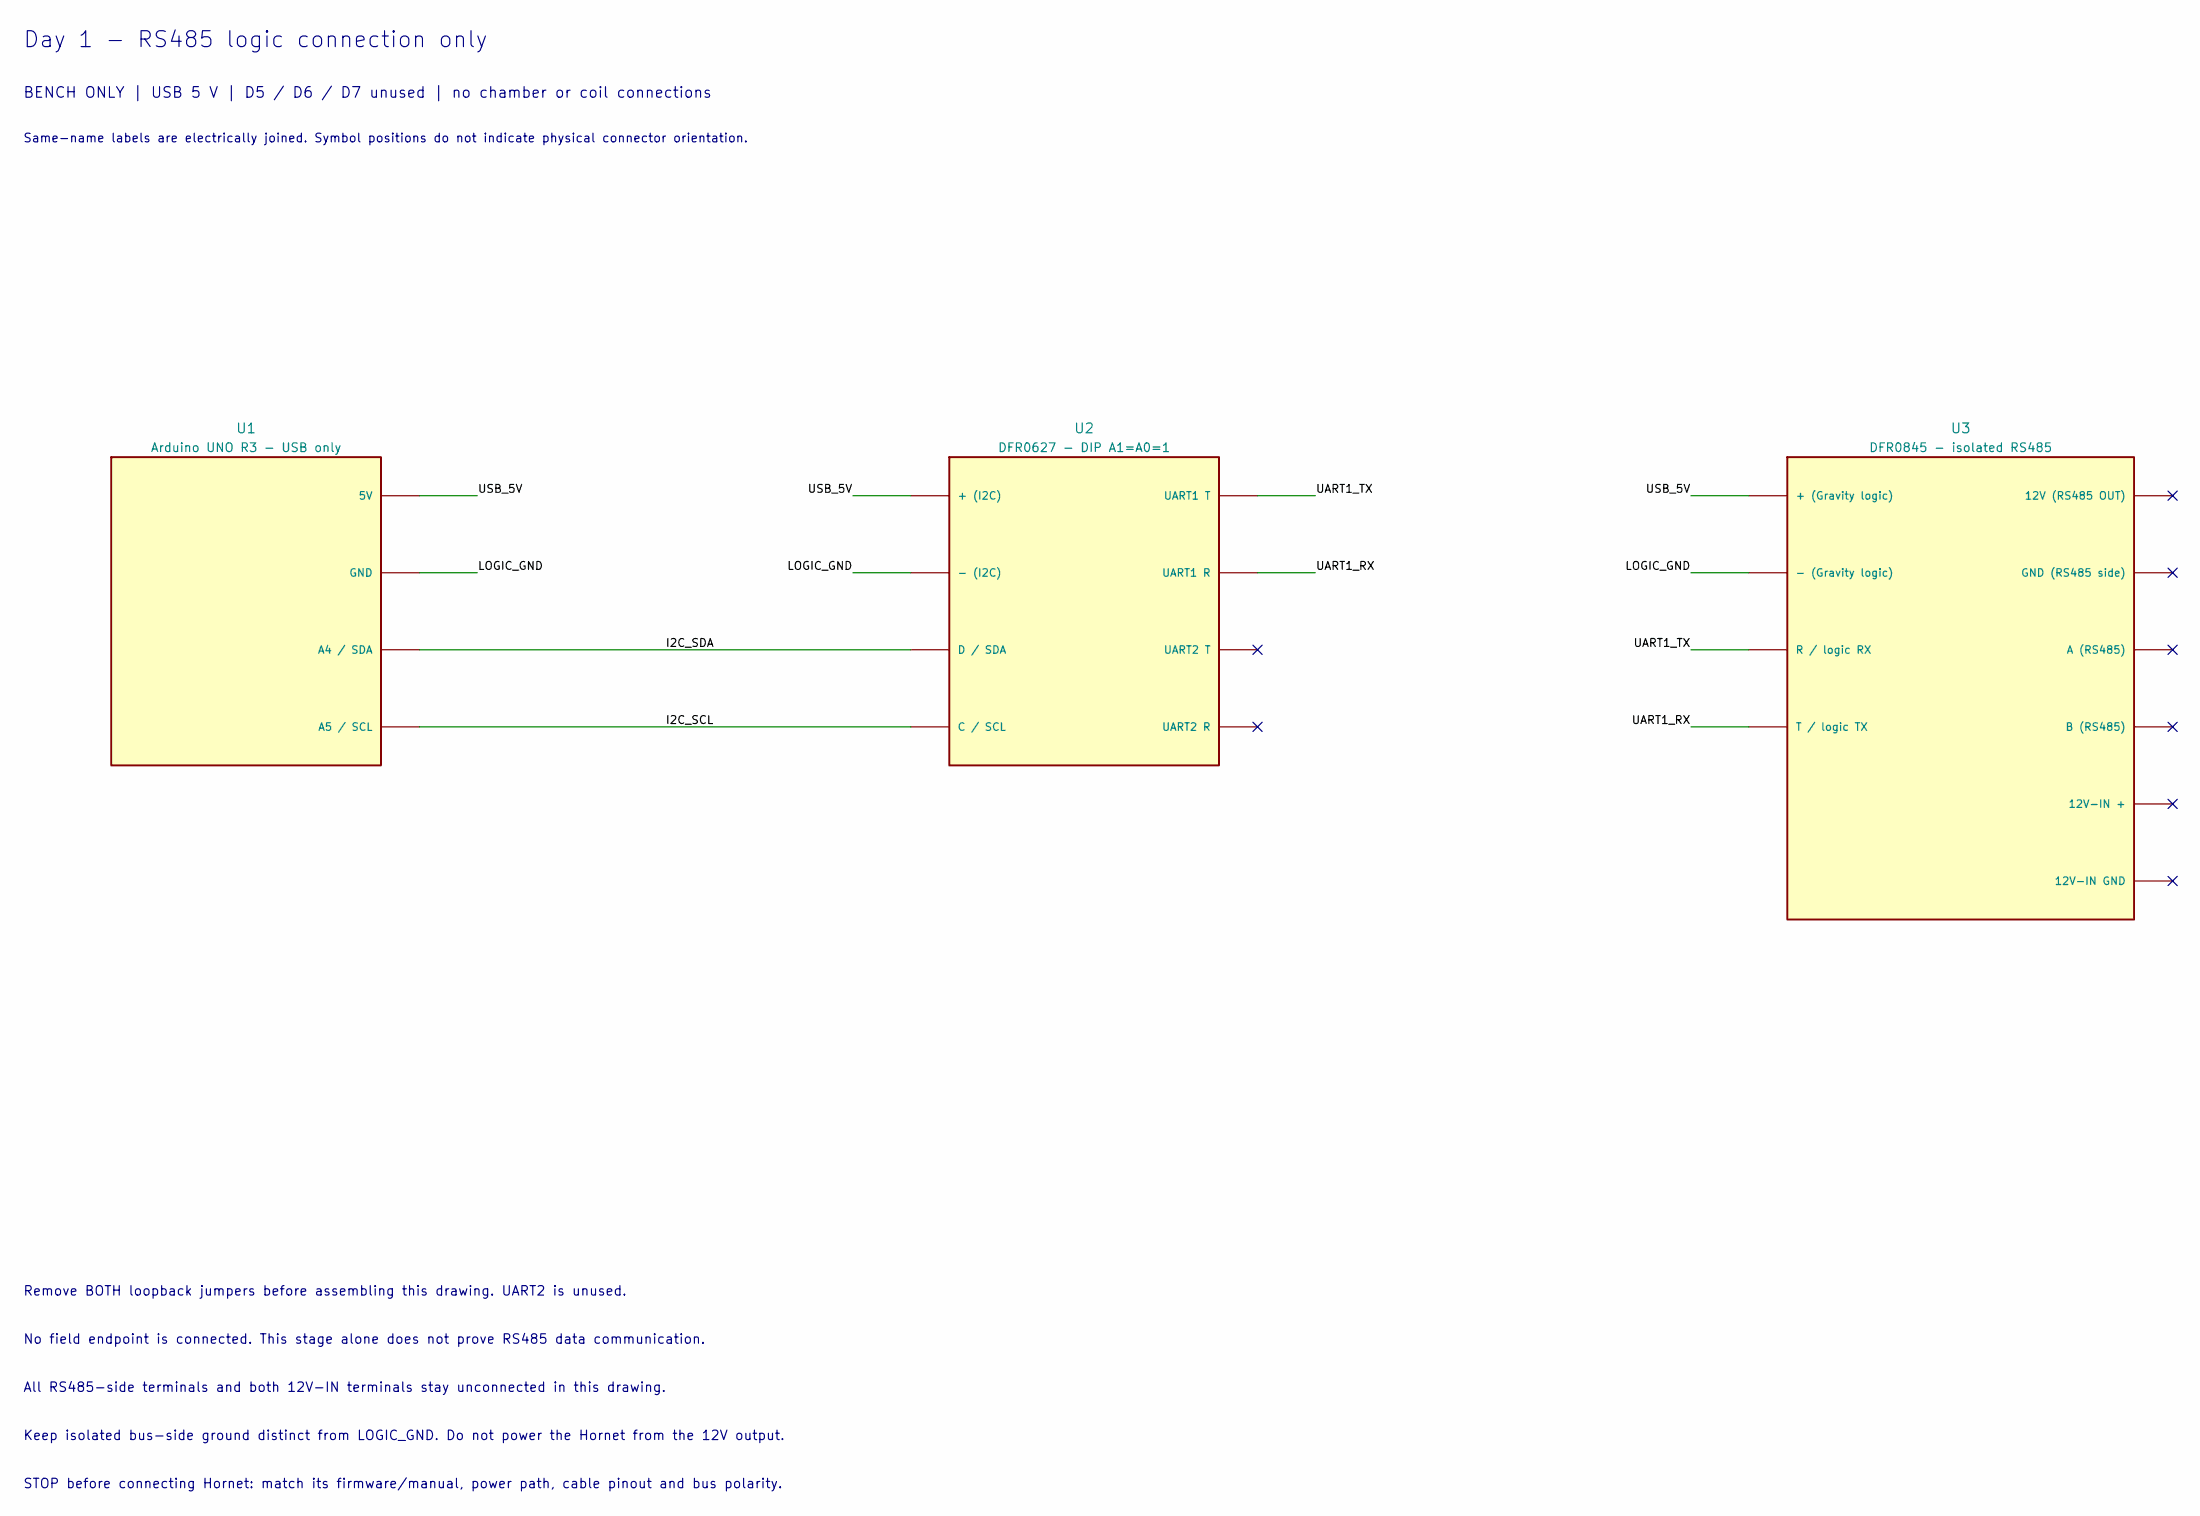
[picture p10: schematic day1-rs485-logic.kicad_sch]

Parts:
U1: Arduino UNO R3 - USB only
U2: DFR0627 - DIP A1=A0=1
U3: DFR0845 - isolated RS485

Connections:
I2C_SCL: U1.A5 (A5 / SCL), U2.SCL (C / SCL)
I2C_SDA: U1.A4 (A4 / SDA), U2.SDA (D / SDA)
LOGIC_GND: U1.GND, U2.MINUS (- (I2C)), U3.MINUS (- (Gravity logic))
UART1_RX: U2.R1 (UART1 R), U3.T (T / logic TX)
UART1_TX: U2.T1 (UART1 T), U3.R (R / logic RX)
USB_5V: U1.5V, U2.PLUS (+ (I2C)), U3.PLUS (+ (Gravity logic))

Notes on the sheet:
Day 1 - RS485 logic connection only
BENCH ONLY | USB 5 V | D5 / D6 / D7 unused | no chamber or coil connections
Same-name labels are electrically joined. Symbol positions do not indicate physical connector orientation.
Remove BOTH loopback jumpers before assembling this drawing. UART2 is unused.
No field endpoint is connected. This stage alone does not prove RS485 data communication.
All RS485-side terminals and both 12V-IN terminals stay unconnected in this drawing.
Keep isolated bus-side ground distinct from LOGIC_GND. Do not power the Hornet from the 12V output.
STOP before connecting Hornet: match its firmware/manual, power path, cable pinout and bus polarity.
