harshddes/VacuumSystem-Arduino/development/bench-prep/kicad/day2-gpio-bench/day2-gpio-bench.kicad_sch

## KiCad design development/bench-prep/kicad/day2-gpio-bench/day2-gpio-bench.kicad_sch (2026-10-20)

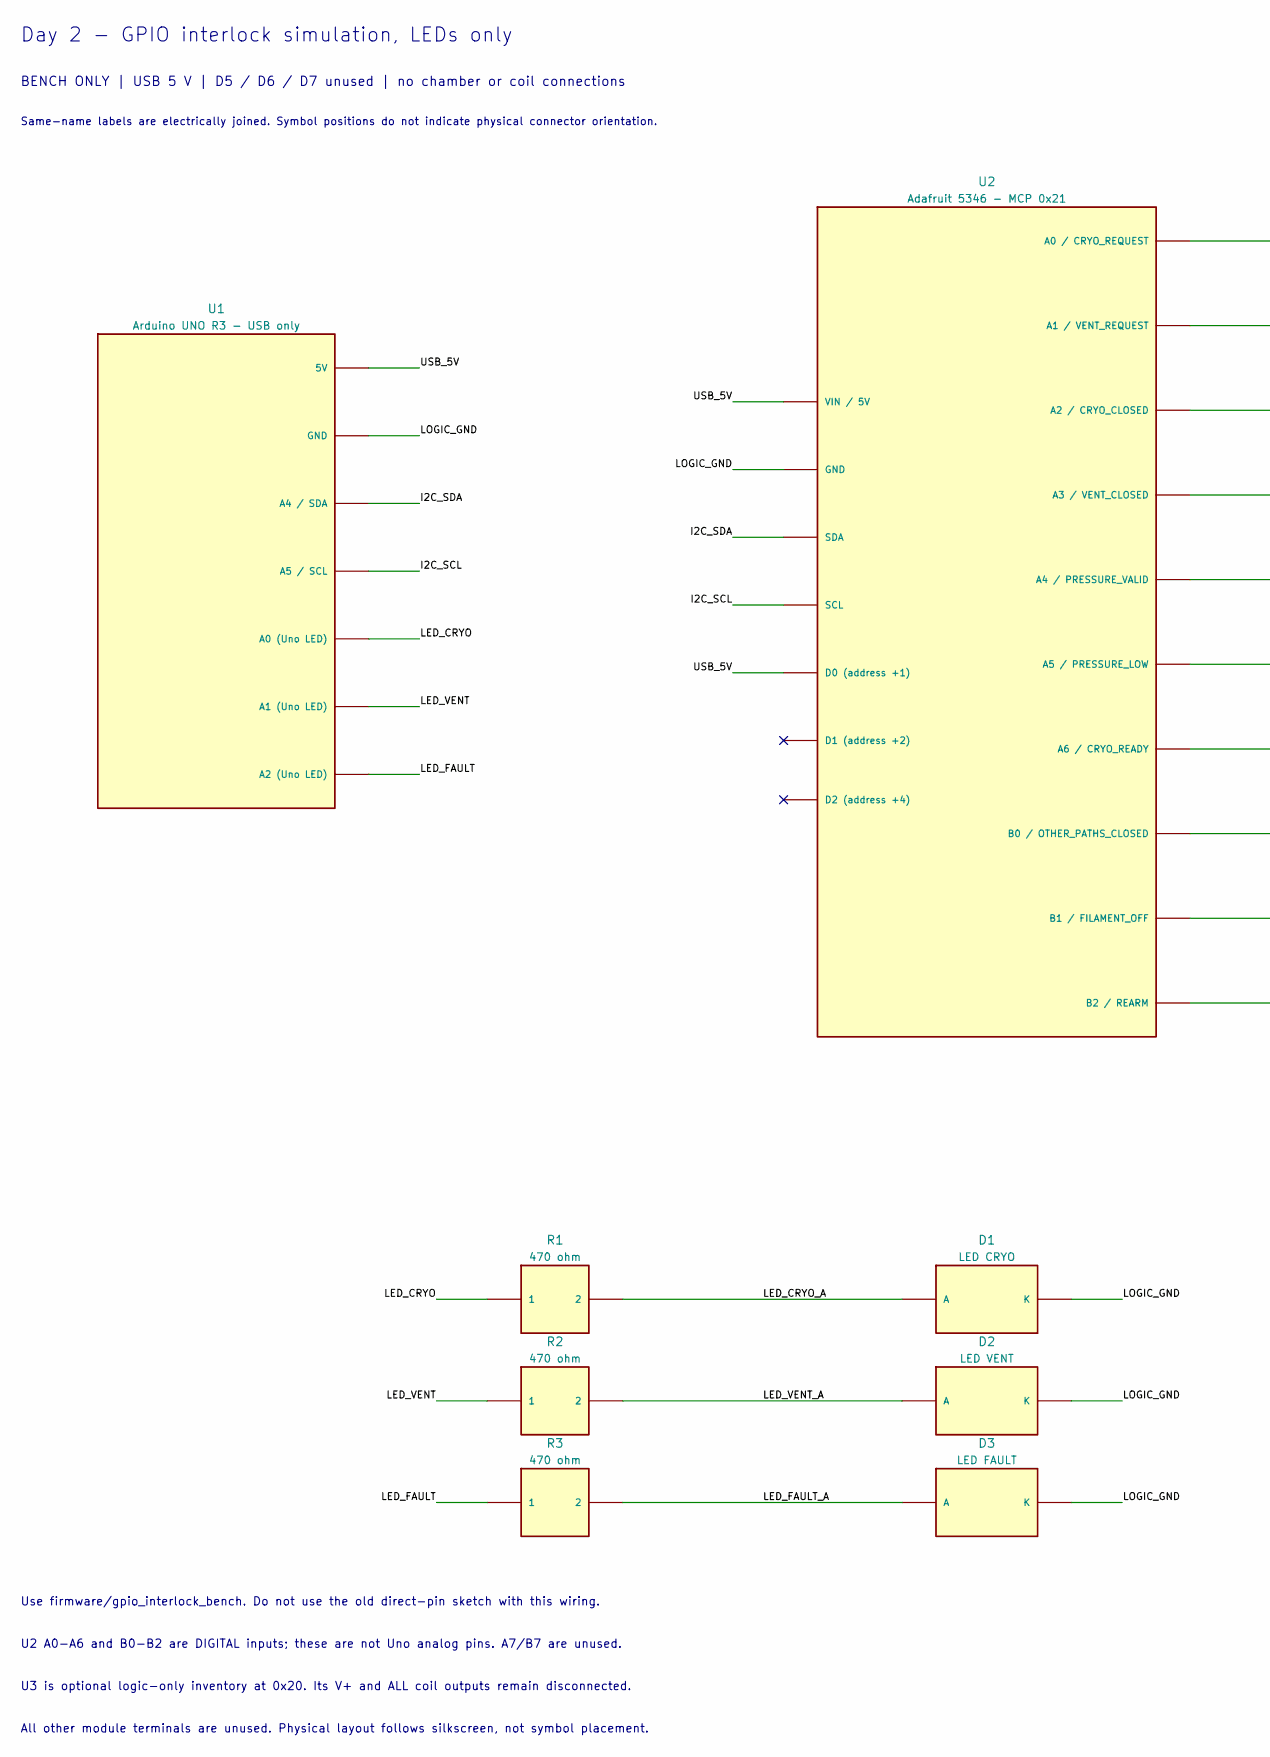
[picture p11: schematic day2-gpio-bench.kicad_sch, part in row 1, column 1]

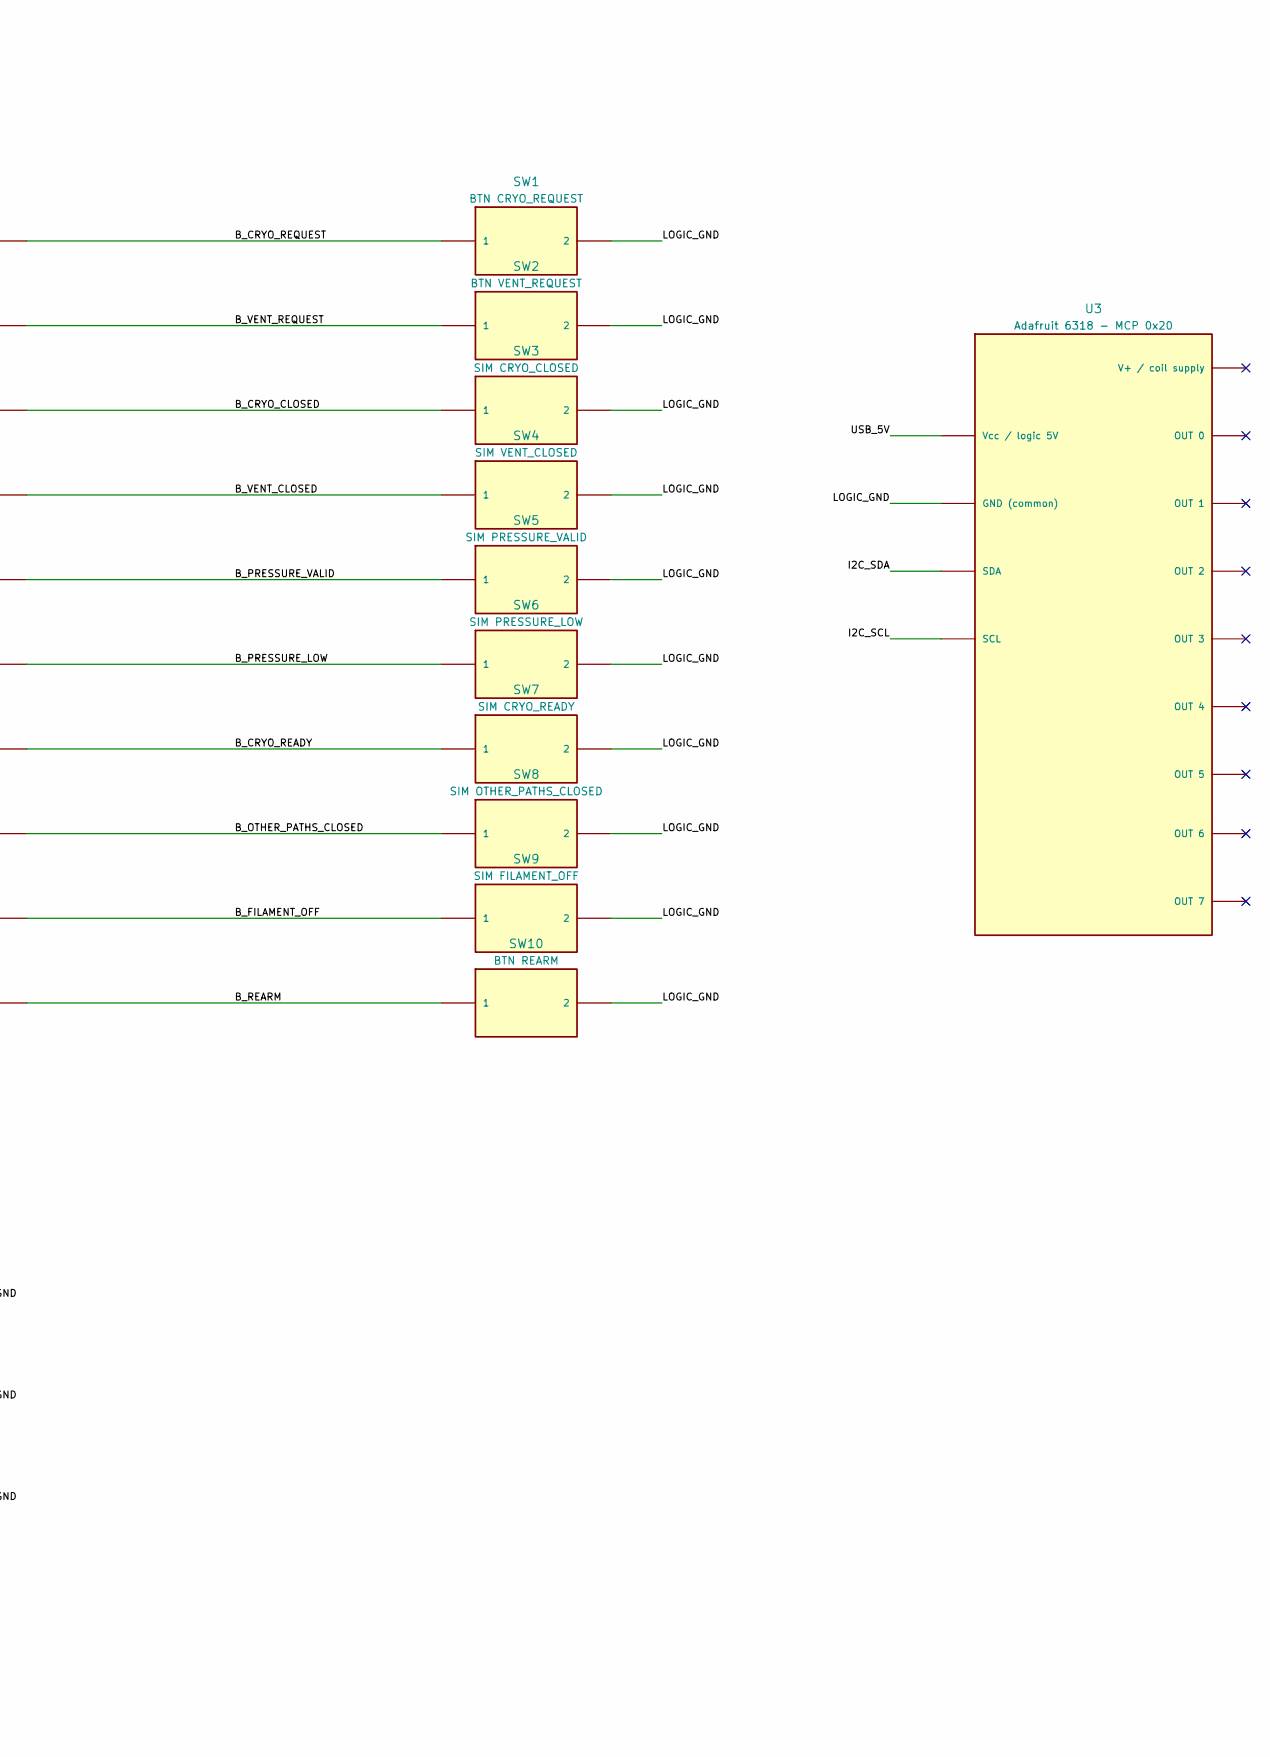
[picture p12: schematic day2-gpio-bench.kicad_sch, part in row 1, column 2]

Parts:
D1: LED CRYO
D2: LED VENT
D3: LED FAULT
R1, R2, R3: 470 ohm
SW1: BTN CRYO_REQUEST
SW2: BTN VENT_REQUEST
SW3: SIM CRYO_CLOSED
SW4: SIM VENT_CLOSED
SW5: SIM PRESSURE_VALID
SW6: SIM PRESSURE_LOW
SW7: SIM CRYO_READY
SW8: SIM OTHER_PATHS_CLOSED
SW9: SIM FILAMENT_OFF
SW10: BTN REARM
U1: Arduino UNO R3 - USB only
U2: Adafruit 5346 - MCP 0x21
U3: Adafruit 6318 - MCP 0x20

Connections:
B_CRYO_CLOSED: SW3.1, U2.A2 (A2 / CRYO_CLOSED)
B_CRYO_READY: SW7.1, U2.A6 (A6 / CRYO_READY)
B_CRYO_REQUEST: SW1.1, U2.A0 (A0 / CRYO_REQUEST)
B_FILAMENT_OFF: SW9.1, U2.B1 (B1 / FILAMENT_OFF)
B_OTHER_PATHS_CLOSED: SW8.1, U2.B0 (B0 / OTHER_PATHS_CLOSED)
B_PRESSURE_LOW: SW6.1, U2.A5 (A5 / PRESSURE_LOW)
B_PRESSURE_VALID: SW5.1, U2.A4 (A4 / PRESSURE_VALID)
B_REARM: SW10.1, U2.B2 (B2 / REARM)
B_VENT_CLOSED: SW4.1, U2.A3 (A3 / VENT_CLOSED)
B_VENT_REQUEST: SW2.1, U2.A1 (A1 / VENT_REQUEST)
I2C_SCL: U1.A5 (A5 / SCL), U2.SCL, U3.SCL
I2C_SDA: U1.A4 (A4 / SDA), U2.SDA, U3.SDA
LED_CRYO: R1.1, U1.A0 (A0 (Uno LED))
LED_CRYO_A: D1.A, R1.2
LED_FAULT: R3.1, U1.A2 (A2 (Uno LED))
LED_FAULT_A: D3.A, R3.2
LED_VENT: R2.1, U1.A1 (A1 (Uno LED))
LED_VENT_A: D2.A, R2.2
LOGIC_GND: D1.K, D2.K, D3.K, SW1.2, SW2.2, SW3.2, SW4.2, SW5.2, SW6.2, SW7.2, SW8.2, SW9.2, SW10.2, U1.GND, U2.GND, U3.GND (GND (common))
USB_5V: U1.5V, U2.ADDR0 (D0 (address +1)), U2.VIN (VIN / 5V), U3.VCC (Vcc / logic 5V)

Notes on the sheet:
Day 2 - GPIO interlock simulation, LEDs only
BENCH ONLY | USB 5 V | D5 / D6 / D7 unused | no chamber or coil connections
Same-name labels are electrically joined. Symbol positions do not indicate physical connector orientation.
Use firmware/gpio_interlock_bench. Do not use the old direct-pin sketch with this wiring.
U2 A0-A6 and B0-B2 are DIGITAL inputs; these are not Uno analog pins. A7/B7 are unused.
U3 is optional logic-only inventory at 0x20. Its V+ and ALL coil outputs remain disconnected.
All other module terminals are unused. Physical layout follows silkscreen, not symbol placement.
