harshddes/VacuumSystem-Arduino/(commit log)

2026-10-09 Record the Uno pin check and board reference as their own project.
    [UNO-TH_Rev3e.brd, UNO-TH_Rev3e.sch, UNOSMD_V3.brd, UNOSMD_V3.sch]
2026-10-09 Add Uno valve-controller development baseline
    Document five build phases, exact Phase 1 wiring, procurement, equipment interfaces, interlock and sequence requirements, editable schematics, bench firmware and acceptance records. Include supplied lab references and 519 passing host logic scenarios; keep field verification explicitly pending.
    [field-io-register.csv, maize-uno-bom.xlsx, test-log.csv]
2026-10-20 Add verified KiCad and Cursor hardware-arrival bench package
    Provide three native KiCad interconnect projects, a fixed 52-connection schedule, module pin map, beginner walkthrough, Cursor project rule and handoff, bundled licensed libraries, and matching UART/GPIO diagnostic sketches. Keep Uno D5-D7 unused and field wiring explicitly pending matched equipment evidence.
    Validate native KiCad connection graphs and renders, 519 core cases, actual GPIO sketch fault/recovery scenarios, and both Uno AVR compile/link targets. Mark all physical acceptance tests NOT TESTED.
    [day1-loopback.kicad_sch, day1-rs485-logic.kicad_sch, day2-gpio-bench.kicad_sch, physical-test-log.csv, pin-map.csv, wire-schedule.csv]
2026-10-24 Consolidate controller status, design decisions and implementation roadmap
    Record the enclosed modular approach, optional custom PCB, full schematic scope, five-phase sequence, required field evidence and release criteria. Distinguish completed bench preparation from unfinished field engineering and physical qualification. Update reported receipt of electronics and point the project and Cursor entrypoints to the current status record.
    Documentation only; no wiring, firmware or physical test results changed.
