harshddes/VacuumSystem-Arduino/(notices)

Notices in the files:
parts and their libraries:
Arduino-utility: Copyright (c) 2016-2017 Arduino LLC. All right reserved.
Arduino-utility: This file is licensed under : CC-SA-BY-NC
